anjalia2/ECE-445-Project/README.md

# Circle of Life: Automated Desktop Aquaponics System

## Team Members: Anjali Aravindhan, Aishwarya Manoj, Estela Medrano-Gutierrez
