anjalia2/ECE-445-Project/notebooks/estela/april24.md

# ECE 445 Lab Notebook
###### By Estela Medrano

---

# Date: April 24, 2026

## Objective

Wire everything up for pre-demo testing.

---

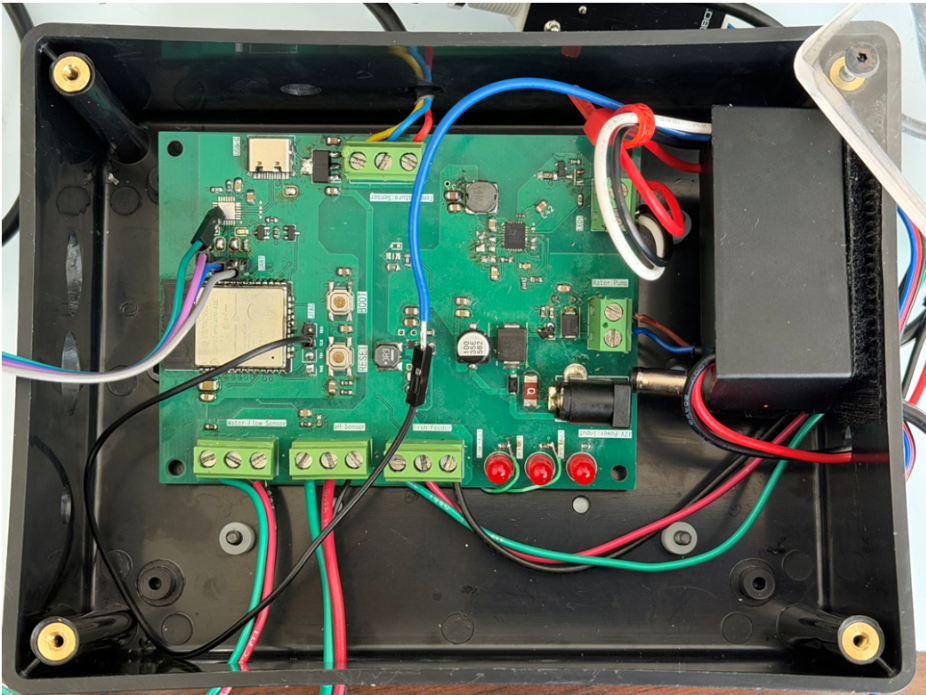
[picture p38: notebooks/estela/Pictures/figure_25.png]
Picture of all
