anjalia2/ECE-445-Project/notebooks/estela/april26.md

# ECE 445 Lab Notebook
###### By Estela Medrano

---

# Date: April 26, 2026

## Objective

Verify voltages.

---

Multimeter tested all voltage measurements:

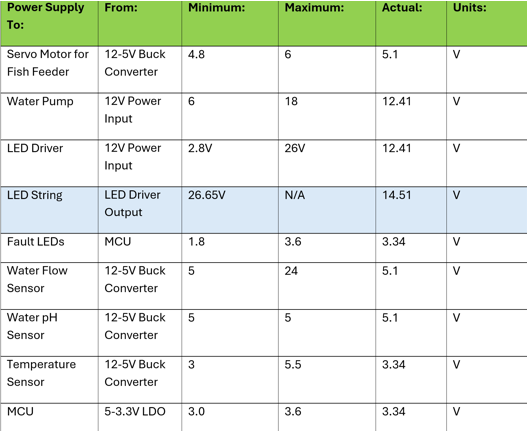
[picture p43: notebooks/estela/Pictures/figure_24.png]
Multimeter measurements
