anjalia2/ECE-445-Project/notebooks/estela/february24.md

# ECE 445 Lab Notebook
###### By Estela Medrano

---

# Date: February 24, 2026

## Objective

Review Anjali’s PCB.

---

Main things to fix:

- Trace width is too small considering the current going through the LEDs.
- As an example, told Anjali that the trace should be compared to the connector hole width and LED pad/current path sizing.
- Told her to change some right angles, should be at least 45 degrees.
- The GND plane and power was switched around.
