anjalia2/ECE-445-Project/notebooks/estela/march24.md

# ECE 445 Lab Notebook
###### By Estela Medrano

---

# Date: March 24, 2026

## Objective

Test 12 V input, solder buck converter, and solder sensors.

---

- Test 12V input, solder buck converter and sensors

- Soldered buck converter and other small ICs. They were tiny. I hand soldered the buck converter, and used solder paste and a heat gun for the LED driver.

- Tested 12V with charger. Measures around 12.41V. A bit higher than expected, but nothing bad.

- Tested buck converter. I worked my first try! Measured around 5.01V

- Soldered all connectors. Will let the others finish testing them whenever they have time. We should be able to do our exact breadboard test in this PCB now.
