anjalia2/ECE-445-Project/notebooks/estela/february27.md

# ECE 445 Lab Notebook
###### By Estela Medrano

---

# Date: February 27, 2026

## Objective

Draw visual aid for design review.

---

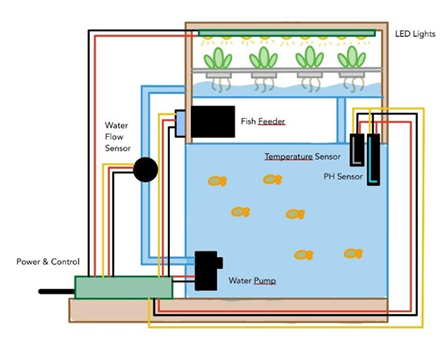
[picture p54: notebooks/estela/Pictures/figure_12.png]
Visual Aid
