anjalia2/ECE-445-Project/notebooks/estela/Pictures/figure_1.png

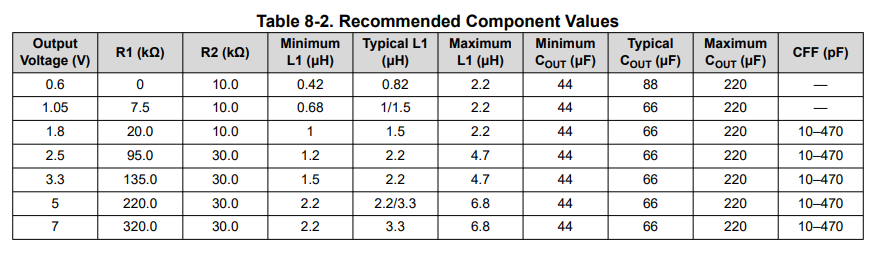
notebooks/estela/Pictures/figure_1.png
