anjalia2/ECE-445-Project/notebooks/estela/Pictures/figure_2.png

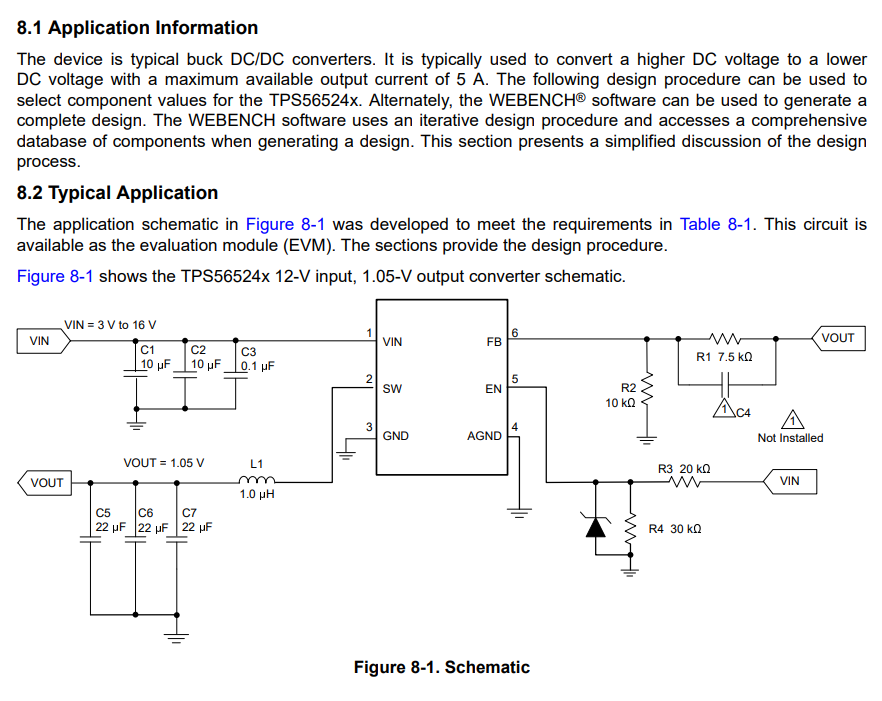
notebooks/estela/Pictures/figure_2.png
