anjalia2/ECE-445-Project/notebooks/estela/Pictures/figure_3.png

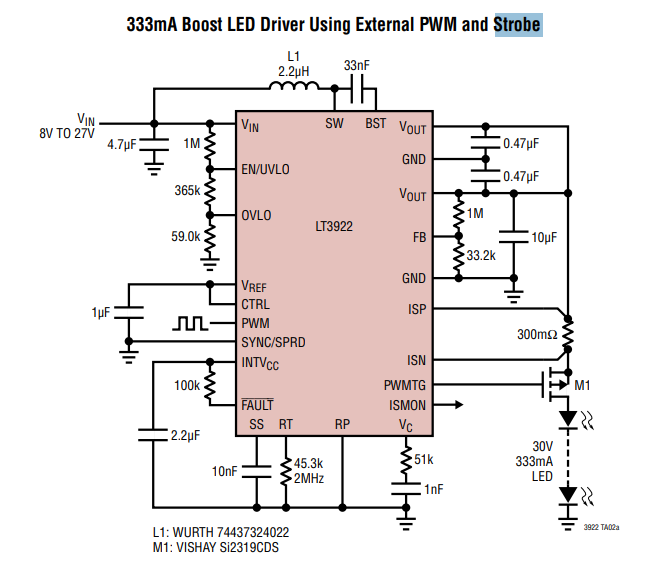
notebooks/estela/Pictures/figure_3.png
