anjalia2/ECE-445-Project/notebooks/estela/Pictures/figure_6.png

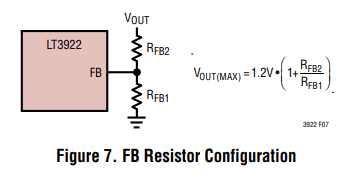
notebooks/estela/Pictures/figure_6.png
