anjalia2/ECE-445-Project/boards/parts/ASMW-LL00-NKM0E.stp

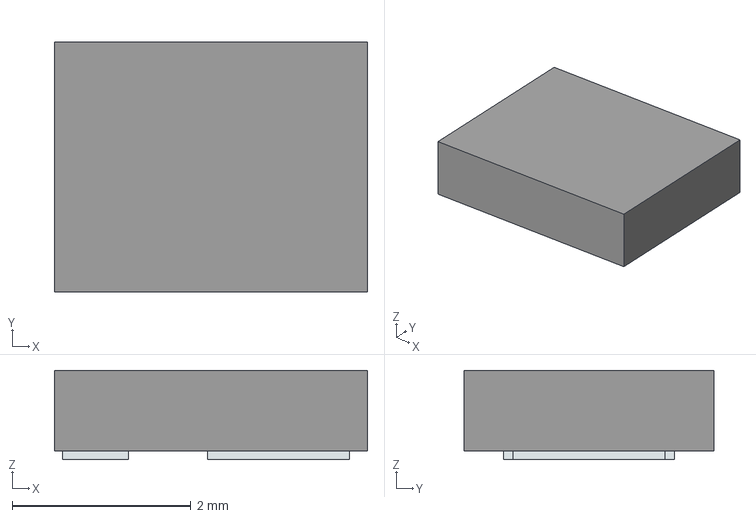
[picture p61: CAD file, 2026-02-19]
boards/parts/ASMW-LL00-NKM0E.stp
3.50 x 2.80 x 1.00 mm
Pins
