anjalia2/ECE-445-Project/boards/parts/ASMW-L300-AFH0E.stp

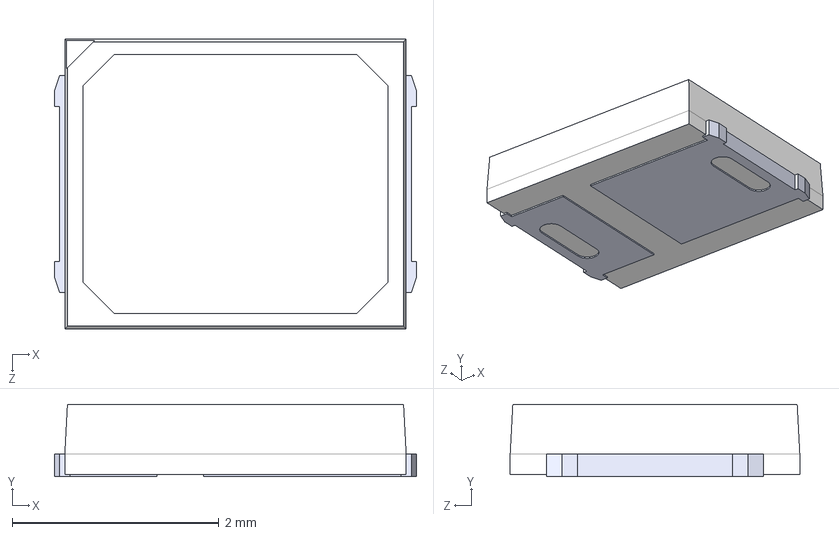
[picture p62: CAD file, 2026-02-19]
boards/parts/ASMW-L300-AFH0E.stp
3.50 x 0.7 x 2.80 mm
