anjalia2/ECE-445-Project/boards/parts/LIB_RC0805FR-0730KL/RC0805FR-0730KL/3D/RC0805FR-0730KL.stp

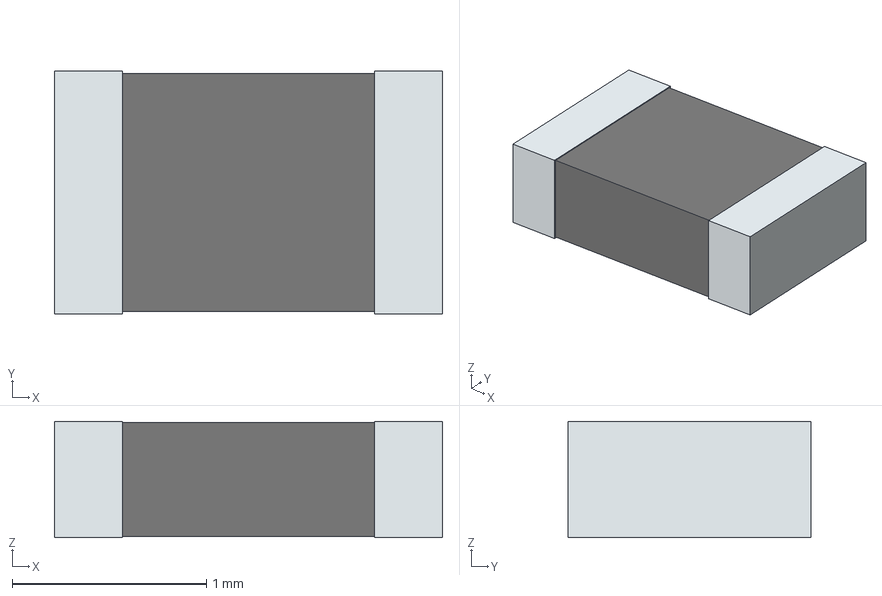
[picture p64: CAD file, 2026-02-20]
boards/parts/LIB_RC0805FR-0730KL/RC0805FR-0730KL/3D/RC0805FR-0730KL.stp
2.00 x 1.25 x 0.6 mm
term1
term2
