anjalia2/ECE-445-Project/boards/parts/SMF12A/SMF12A.step

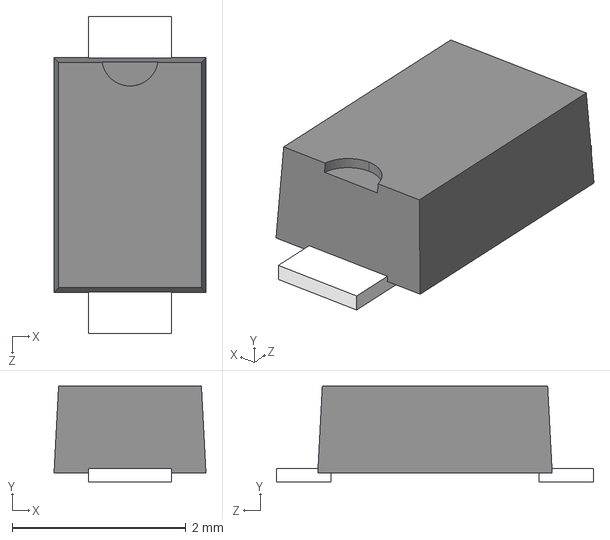
[picture p65: CAD file, 2026-02-20]
boards/parts/SMF12A/SMF12A.step
1.75 x 1.10 x 3.65 mm
