anjalia2/ECE-445-Project/boards/parts/TPD1E05U06QDPYRQ1.stp

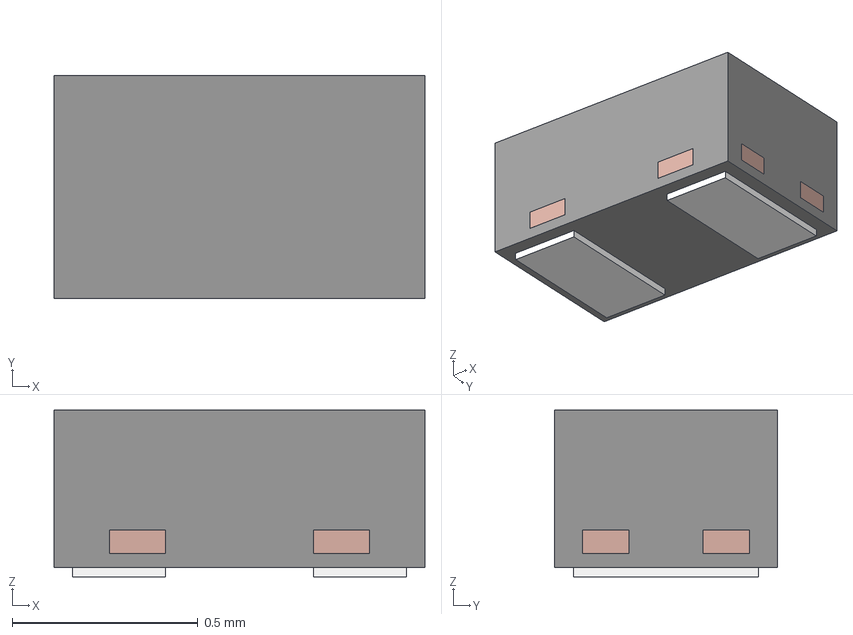
[picture p66: CAD file, 2026-02-23]
boards/parts/TPD1E05U06QDPYRQ1.stp
1.00 x 0.6 x 0.45 mm
BODY-SON
FRAME-DPY0002A
