anjalia2/ECE-445-Project/boards/parts/ESP32-S3-WROOM-1-N8.stp

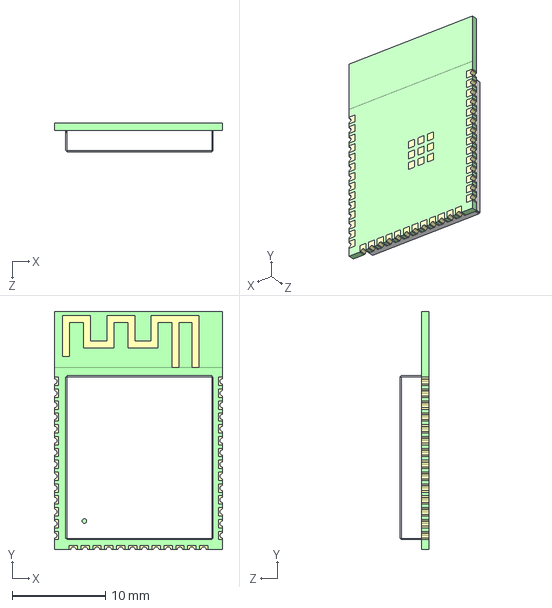
[picture p67: CAD file, 2026-02-23]
boards/parts/ESP32-S3-WROOM-1-N8.stp
18.0 x 25.5 x 3.10 mm
