anjalia2/ECE-445-Project/boards/parts/SP0506BAATG.stp

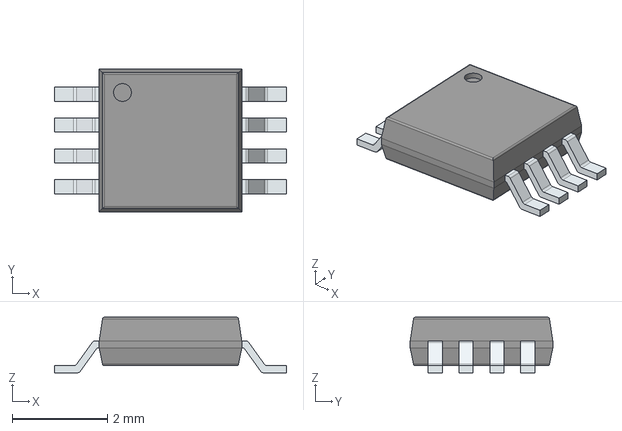
[picture p68: CAD file, 2026-02-21]
boards/parts/SP0506BAATG.stp
4.88 x 3.00 x 1.17 mm
PinsArrayLR
