anjalia2/ECE-445-Project/boards/parts/SS8050-G.stp

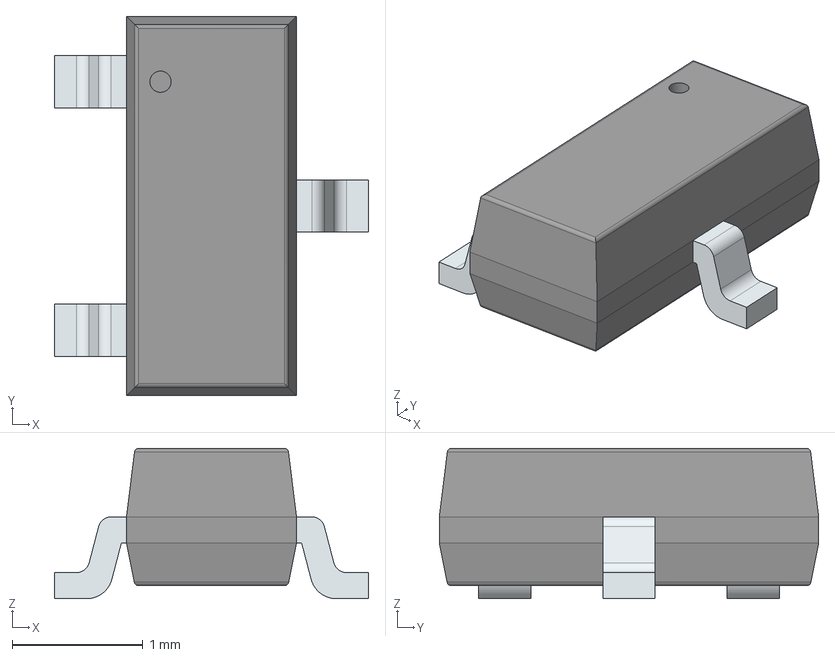
[picture p69: CAD file, 2026-02-21]
boards/parts/SS8050-G.stp
2.40 x 2.90 x 1.15 mm
PinsArrayL
FilletPinR
