anjalia2/ECE-445-Project/boards/parts/CP2102C-A01-GQFN28.stp

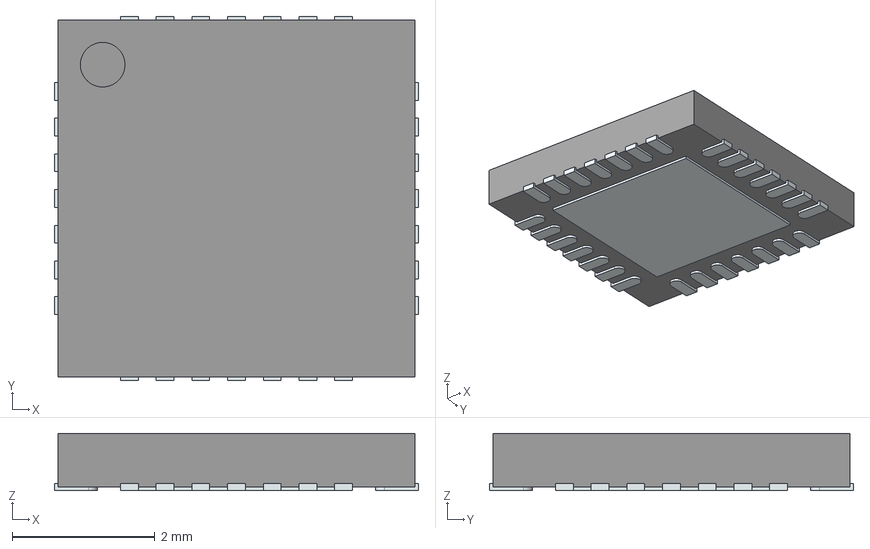
[picture p70: CAD file, 2026-02-21]
boards/parts/CP2102C-A01-GQFN28.stp
5.10 x 5.10 x 0.8 mm
ThermalPin
PinsArrayLR
PinsArrayTB
