anjalia2/ECE-445-Project/boards/parts/SP0503BAHTG.stp

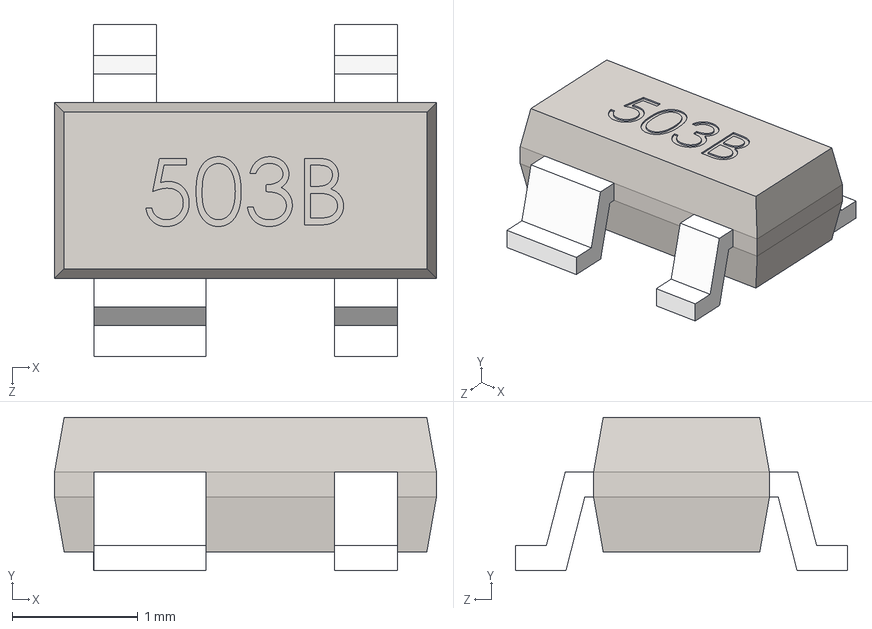
[picture p71: CAD file, 2026-02-21]
boards/parts/SP0503BAHTG.stp
3.04 x 1.22 x 2.64 mm
