anjalia2/ECE-445-Project/boards/parts/TXU0101DBVR.stp

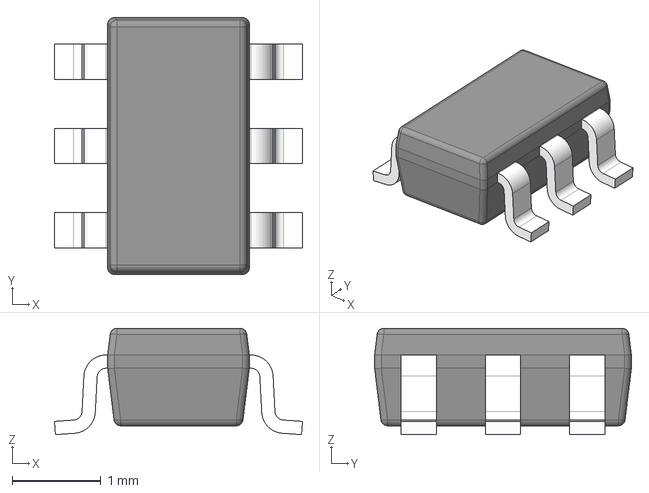
[picture p72: CAD file, 2026-02-20]
boards/parts/TXU0101DBVR.stp
2.80 x 2.90 x 1.20 mm
BODY-SOT
LEAD-SOT x 6
