anjalia2/ECE-445-Project/boards/parts/TC1262-3.3VDB.stp

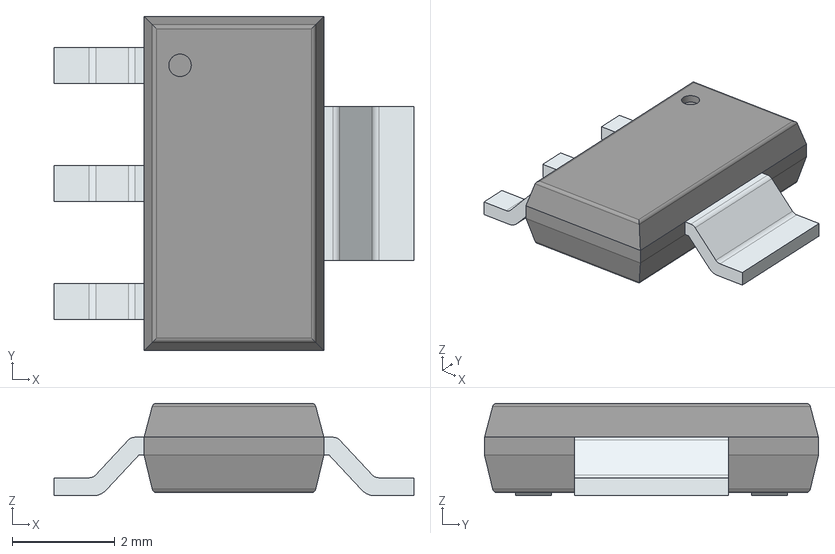
[picture p73: CAD file, 2026-02-20]
boards/parts/TC1262-3.3VDB.stp
7.00 x 6.50 x 1.80 mm
PinsArrayL
FilletPinR
