anjalia2/ECE-445-Project/boards/parts/CSR1206FTR500.stp

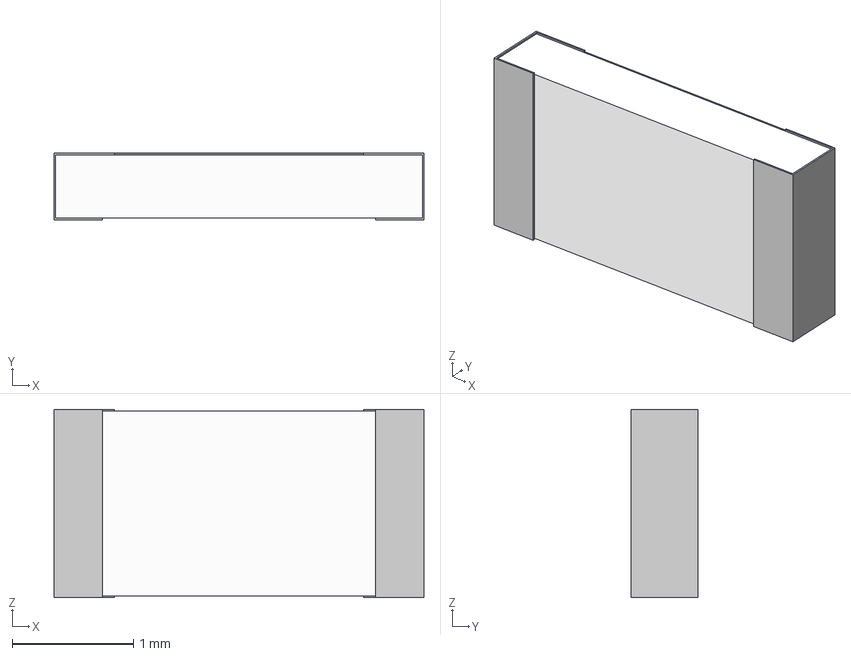
[picture p74: CAD file, 2026-02-20]
boards/parts/CSR1206FTR500.stp
3.05 x 0.55 x 1.55 mm
