anjalia2/ECE-445-Project/boards/parts/SI2319CDS-T1-GE3.stp

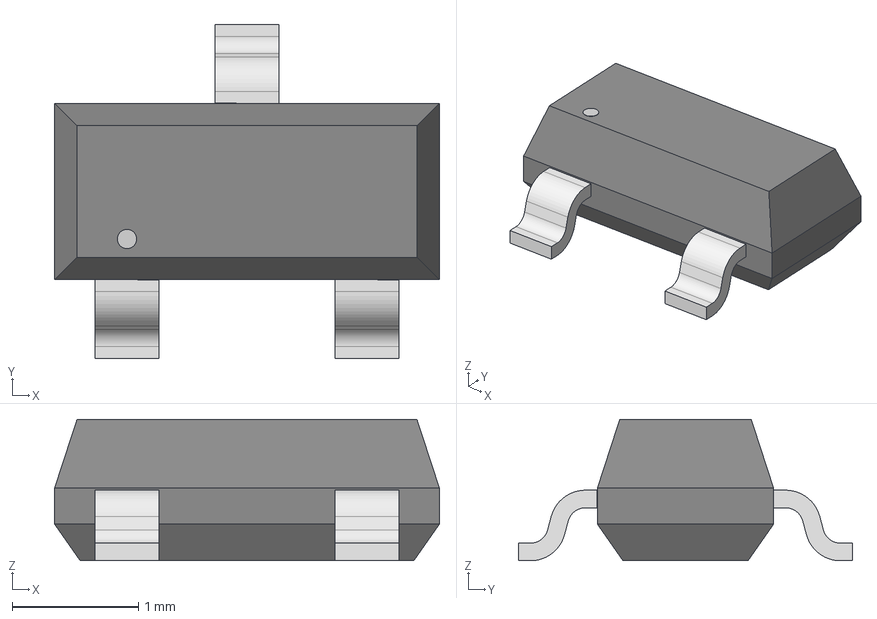
[picture p75: CAD file, 2026-02-20]
boards/parts/SI2319CDS-T1-GE3.stp
3.05 x 2.64 x 1.12 mm
