anjalia2/ECE-445-Project/boards/parts/LT3922EUFD#PBF.stp

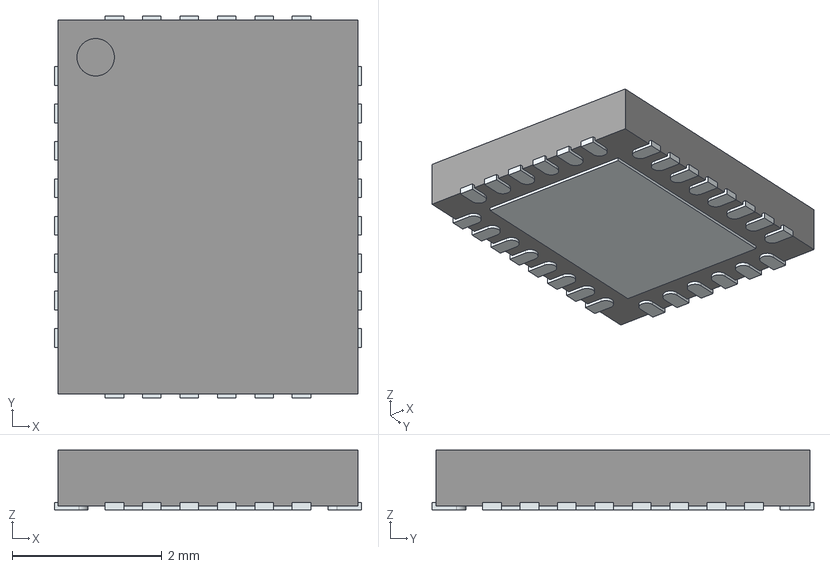
[picture p77: CAD file, 2026-02-20]
boards/parts/LT3922EUFD#PBF.stp
4.10 x 5.10 x 0.8 mm
ThermalPin
PinsArrayLR
PinsArrayTB
