anjalia2/ECE-445-Project/boards/parts/RC0603FR-7W10KL.stp

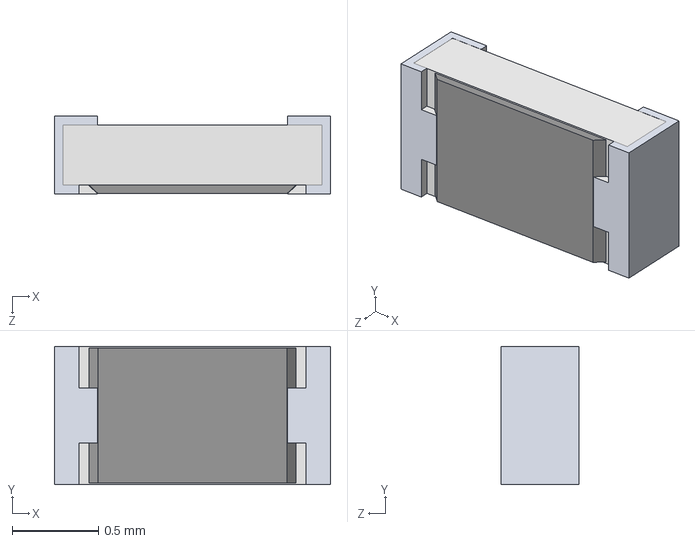
[picture p78: CAD file, 2026-02-20]
boards/parts/RC0603FR-7W10KL.stp
1.60 x 0.8 x 0.45 mm
