anjalia2/ECE-445-Project/boards/parts/RC1206FR-071M1L.stp

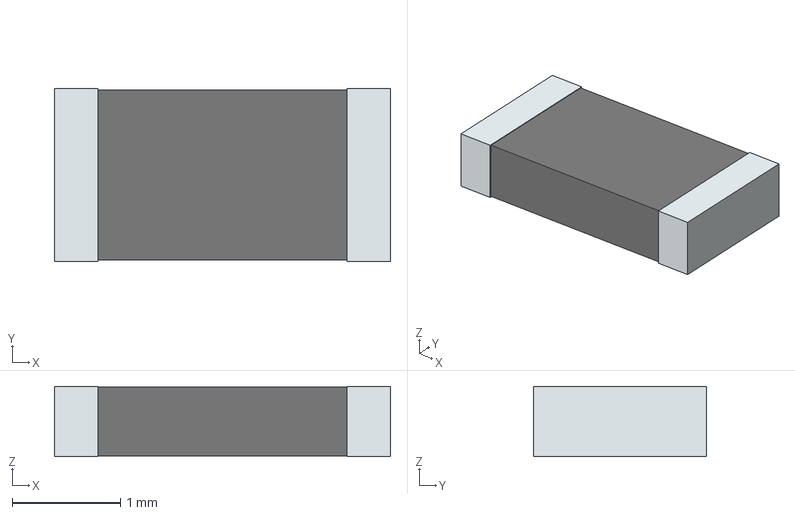
[picture p79: CAD file, 2026-02-20]
boards/parts/RC1206FR-071M1L.stp
3.10 x 1.60 x 0.65 mm
term1
term2
