anjalia2/ECE-445-Project/boards/parts/RCWE1206.STEP

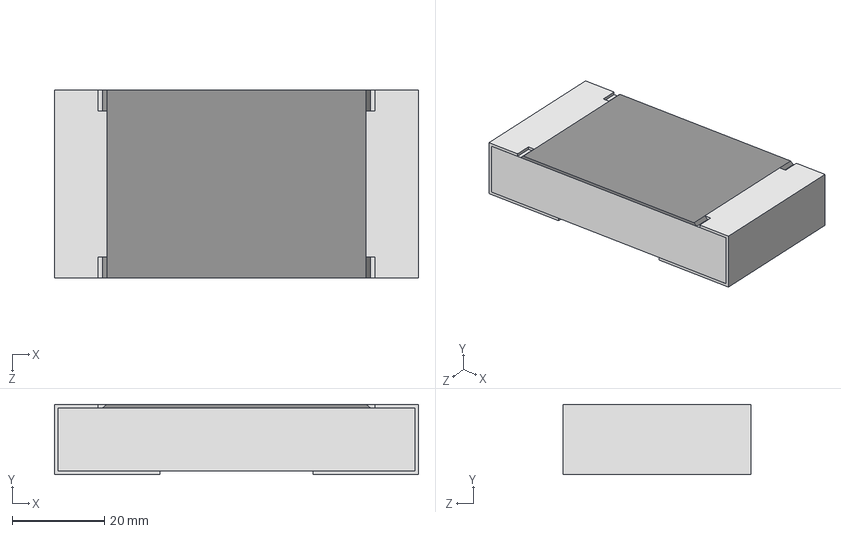
[picture p80: CAD file, 2026-02-20]
boards/parts/RCWE1206.STEP
78.7 x 15.2 x 40.6 mm
