anjalia2/ECE-445-Project/boards/parts/35ZLH220MEFCT78X11.5.stp

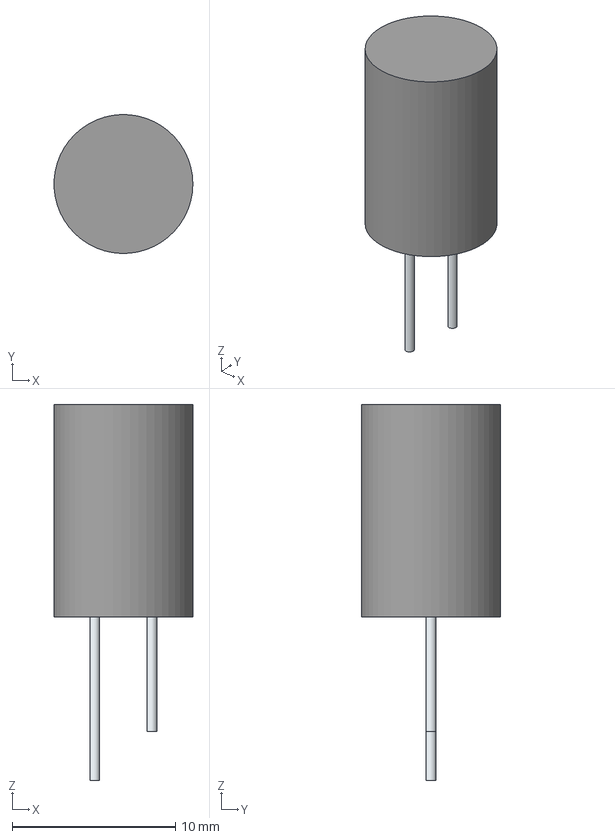
[picture p81: CAD file, 2026-02-20]
boards/parts/35ZLH220MEFCT78X11.5.stp
8.49 x 8.50 x 23.0 mm
SimpleBody
Pin1
Pin2
