anjalia2/ECE-445-Project/boards/parts/TMK107ABJ225KA-T.stp

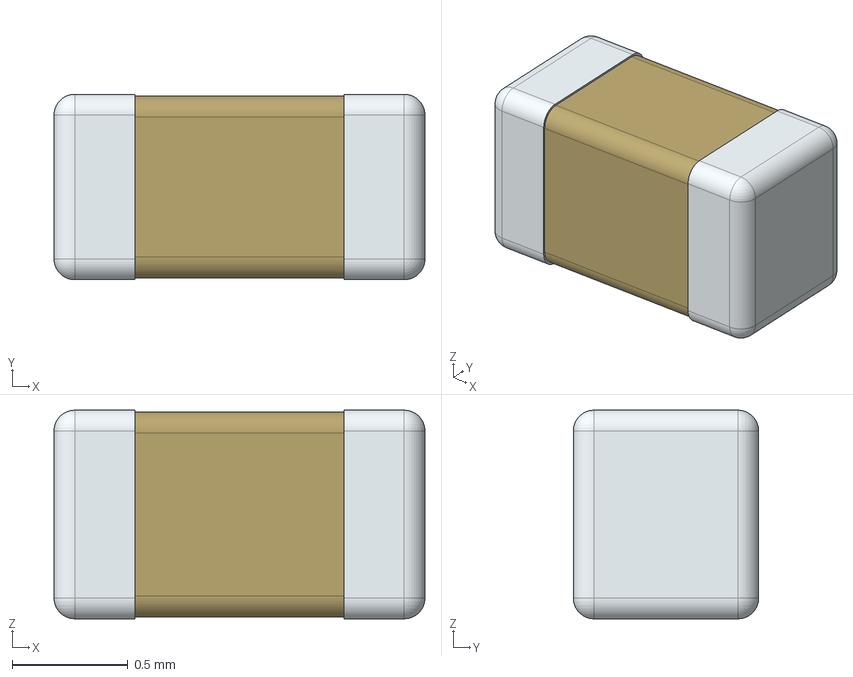
[picture p82: CAD file, 2026-02-20]
boards/parts/TMK107ABJ225KA-T.stp
1.60 x 0.8 x 0.9 mm
