anjalia2/ECE-445-Project/boards/parts/C0603C103K5RACTU.stp

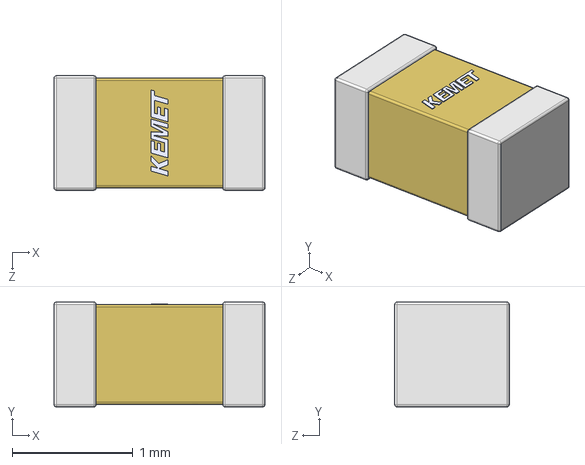
[picture p83: CAD file, 2026-02-20]
boards/parts/C0603C103K5RACTU.stp
1.75 x 0.87 x 0.95 mm
