anjalia2/ECE-445-Project/boards/parts/35PX470MEFC10X12.5.stp

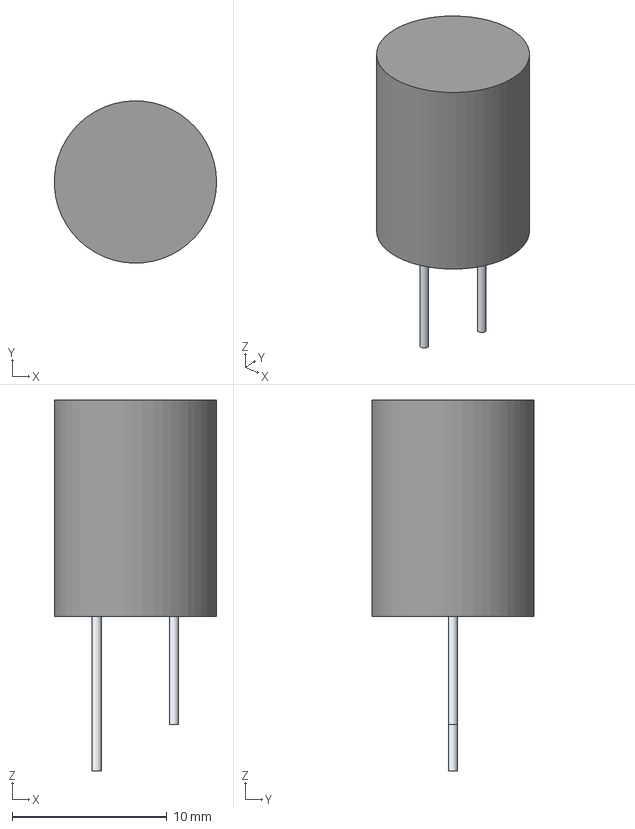
[picture p84: CAD file, 2026-02-20]
boards/parts/35PX470MEFC10X12.5.stp
10.5 x 10.5 x 24.0 mm
SimpleBody
Pin1
Pin2
