anjalia2/ECE-445-Project/boards/parts/NRS5030T3R3MMGJ.stp

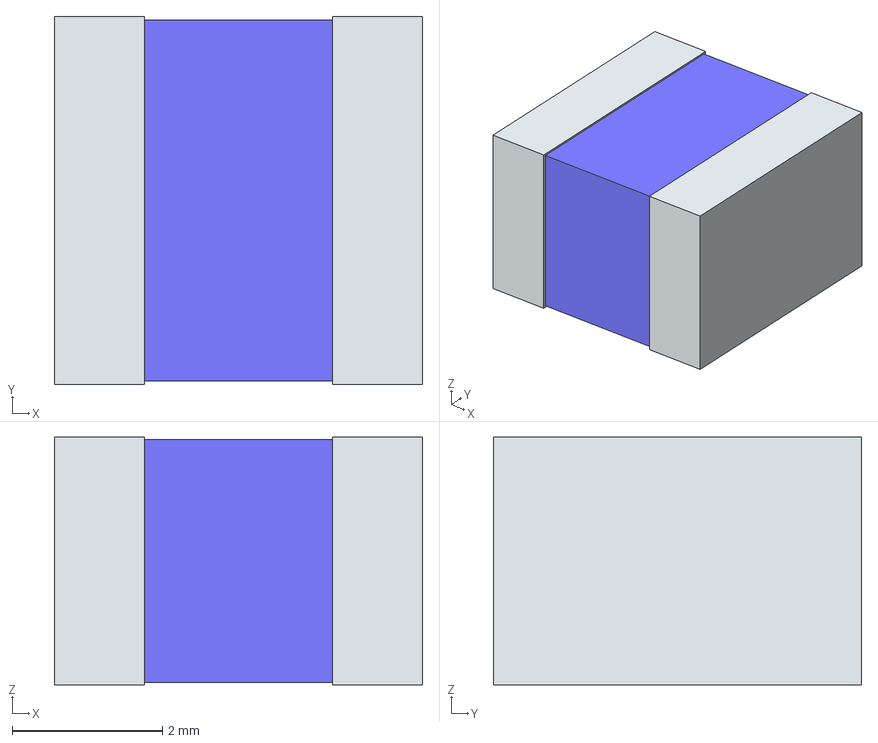
[picture p85: CAD file, 2026-02-20]
boards/parts/NRS5030T3R3MMGJ.stp
4.90 x 4.90 x 3.30 mm
term1
term2
