anjalia2/ECE-445-Project/boards/parts/GRM155R61H474KE11D.stp

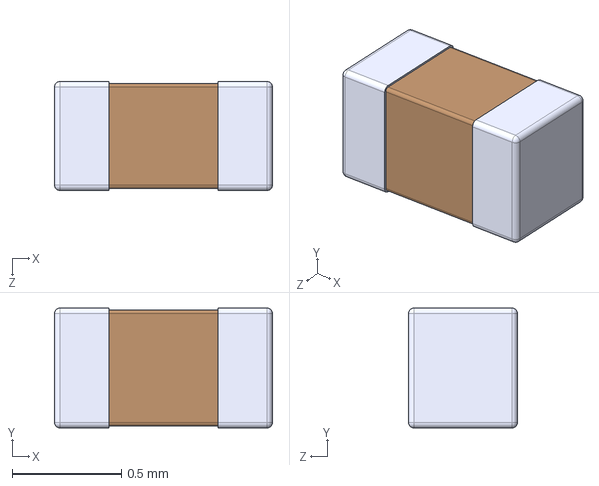
[picture p86: CAD file, 2026-02-20]
boards/parts/GRM155R61H474KE11D.stp
1.00 x 0.55 x 0.5 mm
