anjalia2/ECE-445-Project/boards/parts/GRM155R71H102KA01D.stp

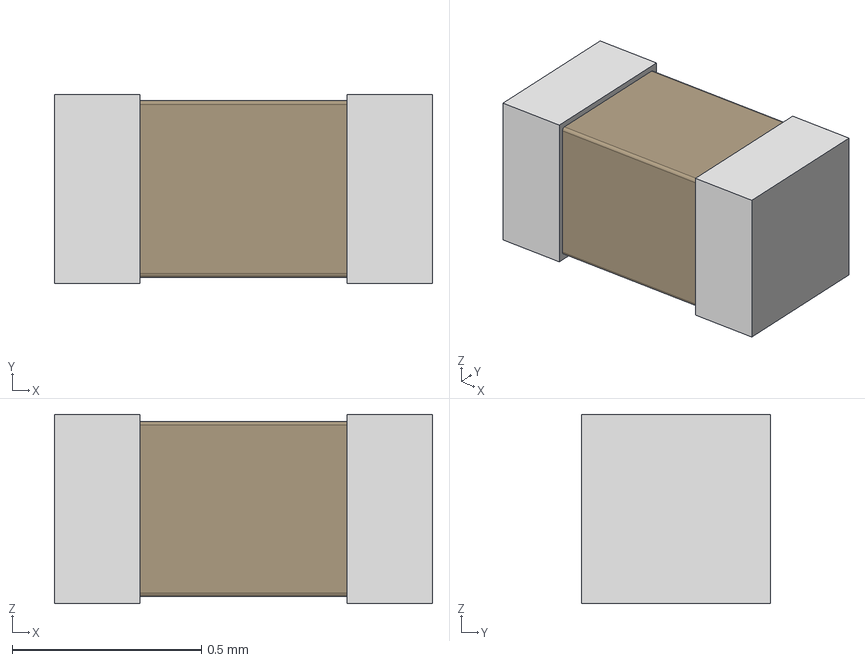
[picture p87: CAD file, 2026-02-20]
boards/parts/GRM155R71H102KA01D.stp
1.00 x 0.5 x 0.5 mm
