anjalia2/ECE-445-Project/boards/parts/TMK316BBJ226ML-T.stp

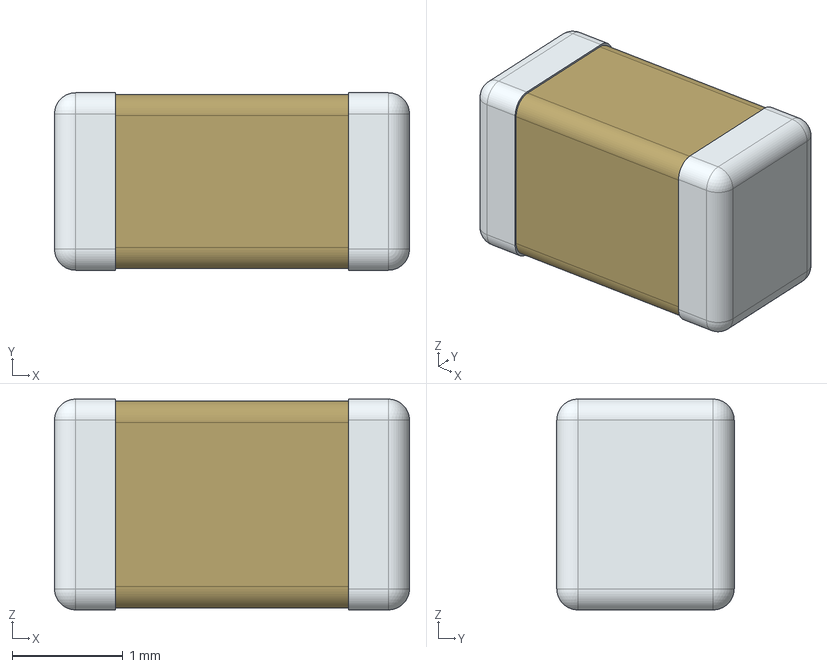
[picture p88: CAD file, 2026-02-20]
boards/parts/TMK316BBJ226ML-T.stp
3.20 x 1.60 x 1.90 mm
