anjalia2/ECE-445-Project/boards/parts/TMK316BJ106KL-T.stp

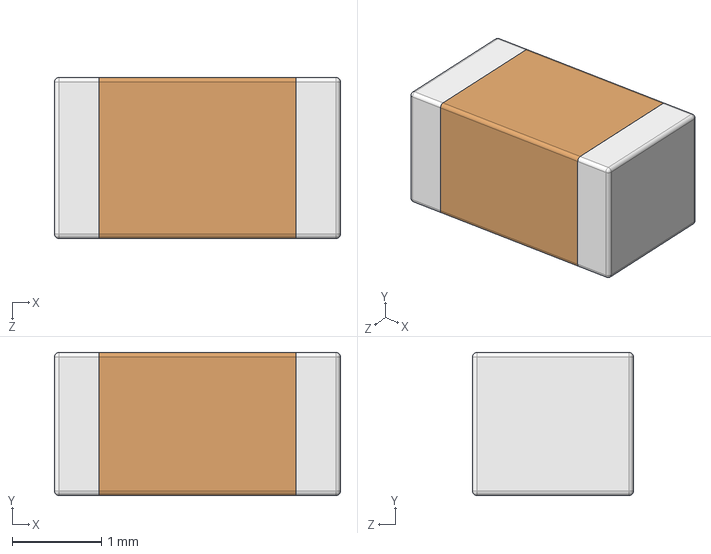
[picture p89: CAD file, 2026-02-20]
boards/parts/TMK316BJ106KL-T.stp
3.20 x 1.60 x 1.80 mm
