anjalia2/ECE-445-Project/boards/parts/50YXJ47M6.3X11.stp

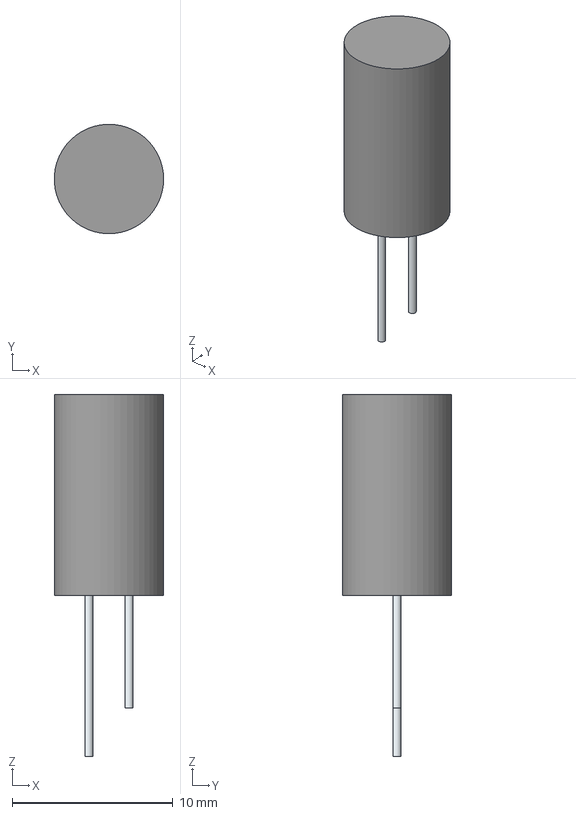
[picture p90: CAD file, 2026-02-20]
boards/parts/50YXJ47M6.3X11.stp
6.79 x 6.80 x 22.5 mm
SimpleBody
Pin1
Pin2
