anjalia2/ECE-445-Project/boards/parts/SRN6045-4R7Y.stp

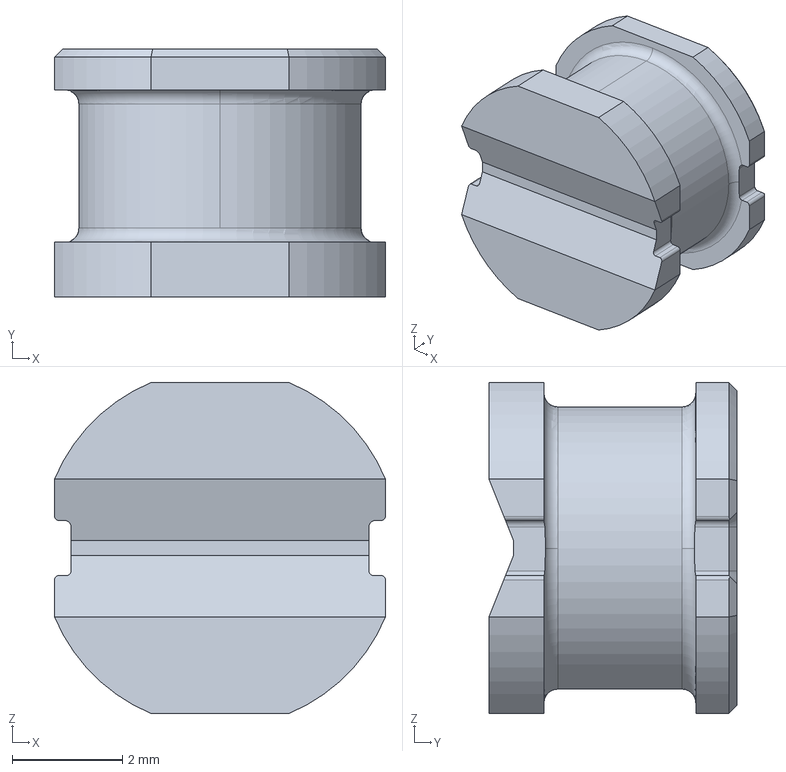
[picture p91: CAD file, 2026-02-20]
boards/parts/SRN6045-4R7Y.stp
6.00 x 4.50 x 6.00 mm
