anjalia2/ECE-445-Project/boards/parts/SK84LQ-TP.stp

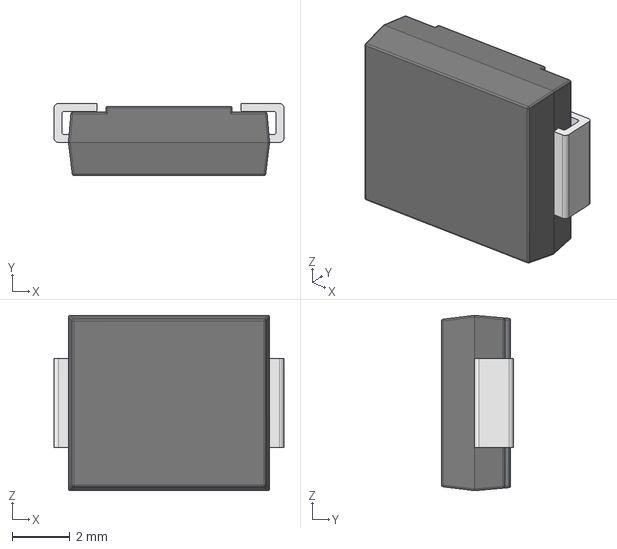
[picture p92: CAD file, 2026-02-19]
boards/parts/SK84LQ-TP.stp
8.00 x 2.50 x 6.10 mm
��2
��1
