anjalia2/ECE-445-Project/boards/parts/BZT52C12-13-F.stp

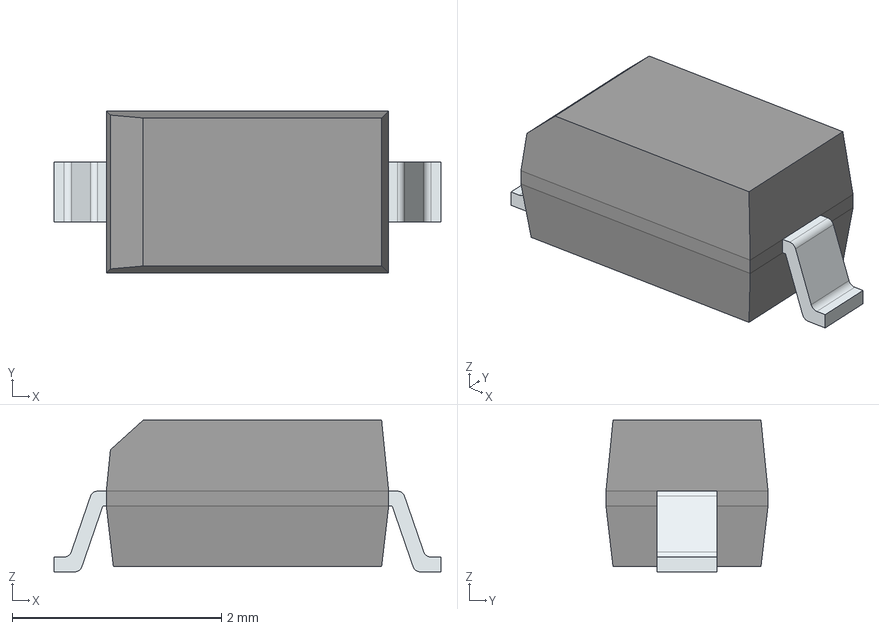
[picture p93: CAD file, 2026-02-19]
boards/parts/BZT52C12-13-F.stp
3.70 x 1.55 x 1.45 mm
FilletPinL
FilletPinR
