anjalia2/ECE-445-Project/boards/parts/RQ5E030AJTCL.stp

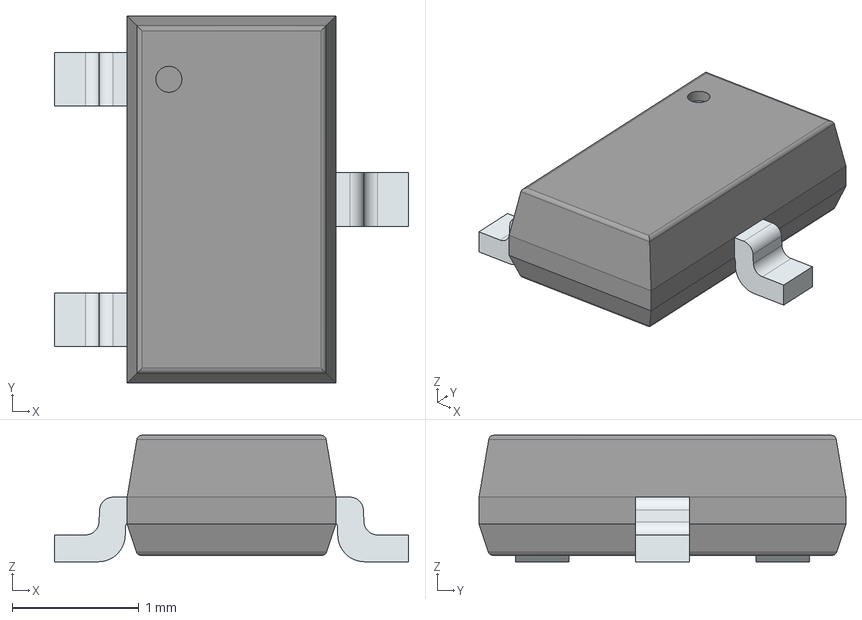
[picture p94: CAD file, 2026-02-19]
boards/parts/RQ5E030AJTCL.stp
2.80 x 2.90 x 1.00 mm
PinsArrayL
FilletPinR
