anjalia2/ECE-445-Project/boards/parts/EEV107M035A9HAA.stp

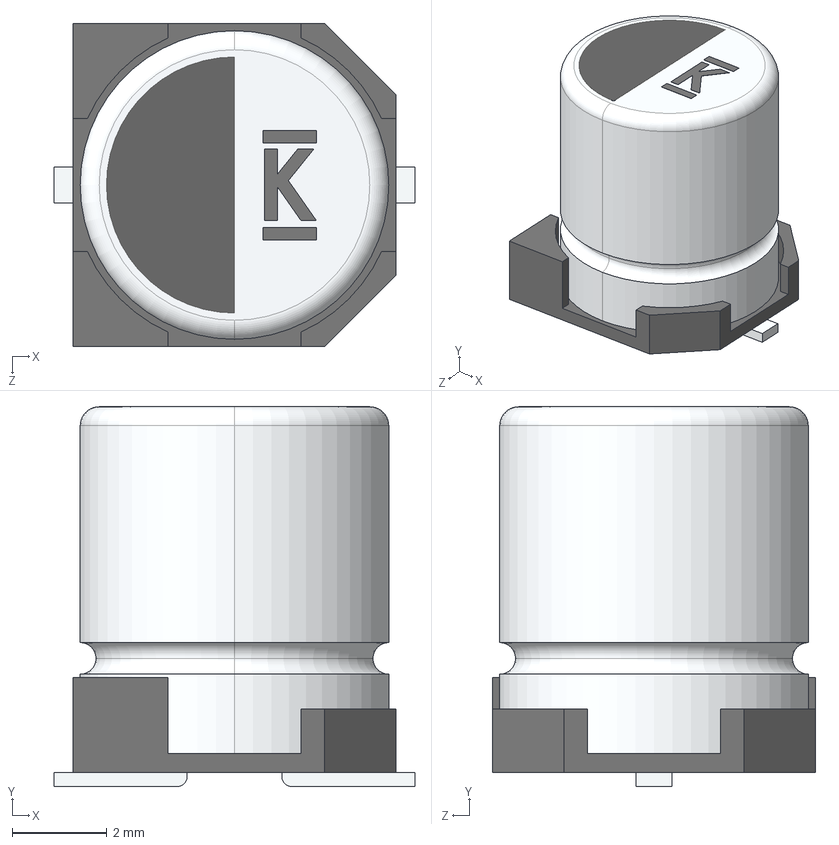
[picture p95: CAD file, 2026-02-19]
boards/parts/EEV107M035A9HAA.stp
7.60 x 8.01 x 6.80 mm
