anjalia2/ECE-445-Project/boards/parts/SF-2410FP1000W-2.stp

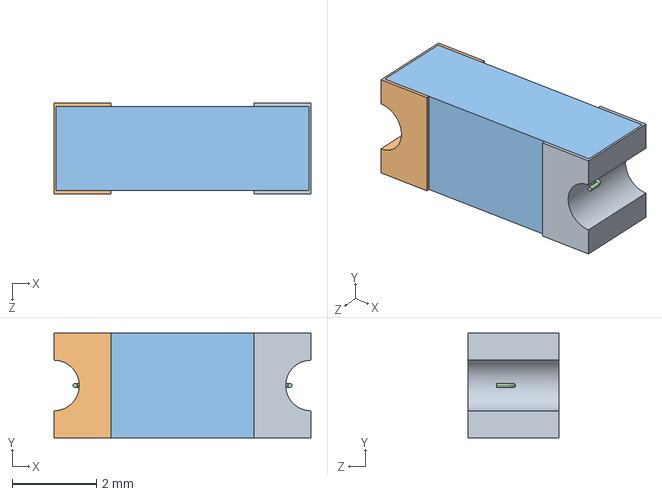
[picture p96: CAD file, 2026-02-19]
boards/parts/SF-2410FP1000W-2.stp
6.10 x 2.49 x 2.16 mm
