anjalia2/ECE-445-Project/boards/parts/GMK212B7105KG-T.stp

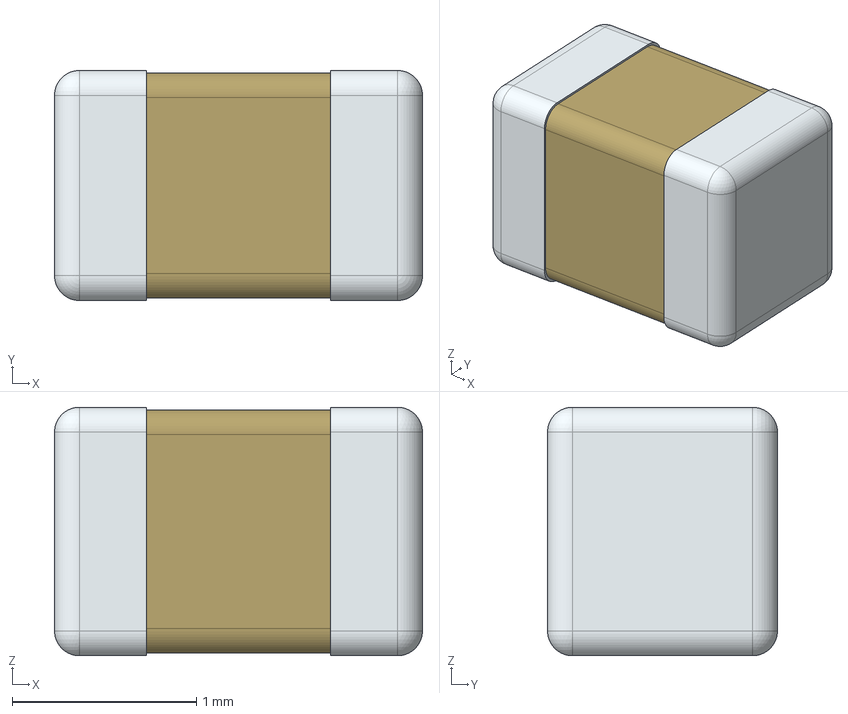
[picture p97: CAD file, 2026-02-19]
boards/parts/GMK212B7105KG-T.stp
2.00 x 1.25 x 1.35 mm
