anjalia2/ECE-445-Project/boards/parts/SS24.stp

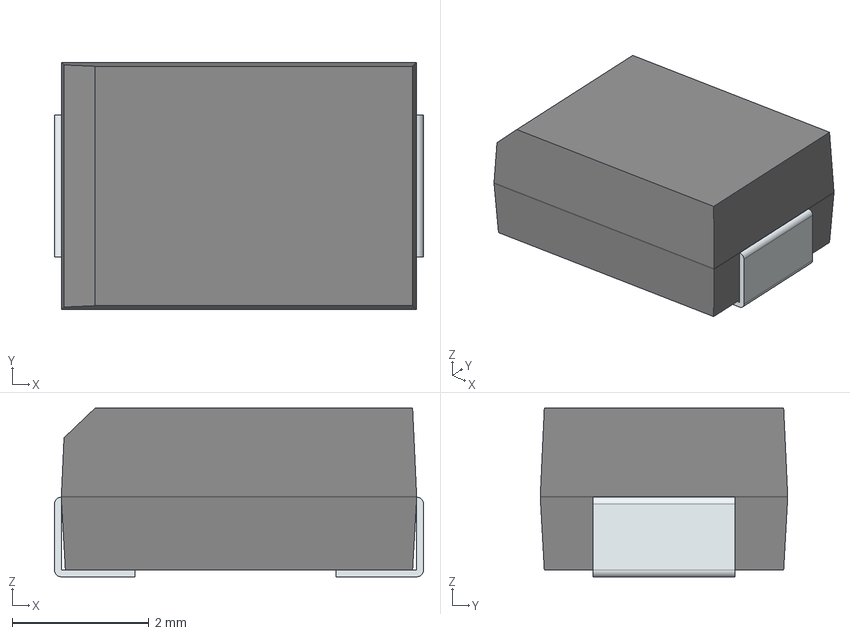
[picture p98: CAD file, 2026-02-19]
boards/parts/SS24.stp
5.41 x 3.62 x 2.47 mm
FilletPin1
FilletPin2
