anjalia2/ECE-445-Project/(list of files, cad)

Other CAD files:
boards/parts/GMK107B7104KAHT.stp
boards/parts/282837-2.stp
boards/parts/691137710003.stp
boards/parts/694108301002.stp
boards/parts/LIB_RC0805FR-0730KL/RC0805FR-0730KL/DEHDL/rc0805fr_0730kl/chips/chips.prt
boards/parts/TPS565242DRLR.stp
