anjalia2/ECE-445-Project/(list of files, drawings)

Other design files:
boards/parts/LIB_RC0805FR-0730KL/RC0805FR-0730KL/Altium/RC0805FR-0730KL.SchLib
boards/parts/LIB_RC0805FR-0730KL/RC0805FR-0730KL/Altium/RESC2012X60N.PcbLib
