anjalia2/ECE-445-Project/boards/circle_of_life_v3/circle_of_life_v2/circle_of_life_v2.kicad_pcb

## KiCad design boards/circle_of_life_v3/circle_of_life_v2/circle_of_life_v2.kicad_pcb (2026-05-07)

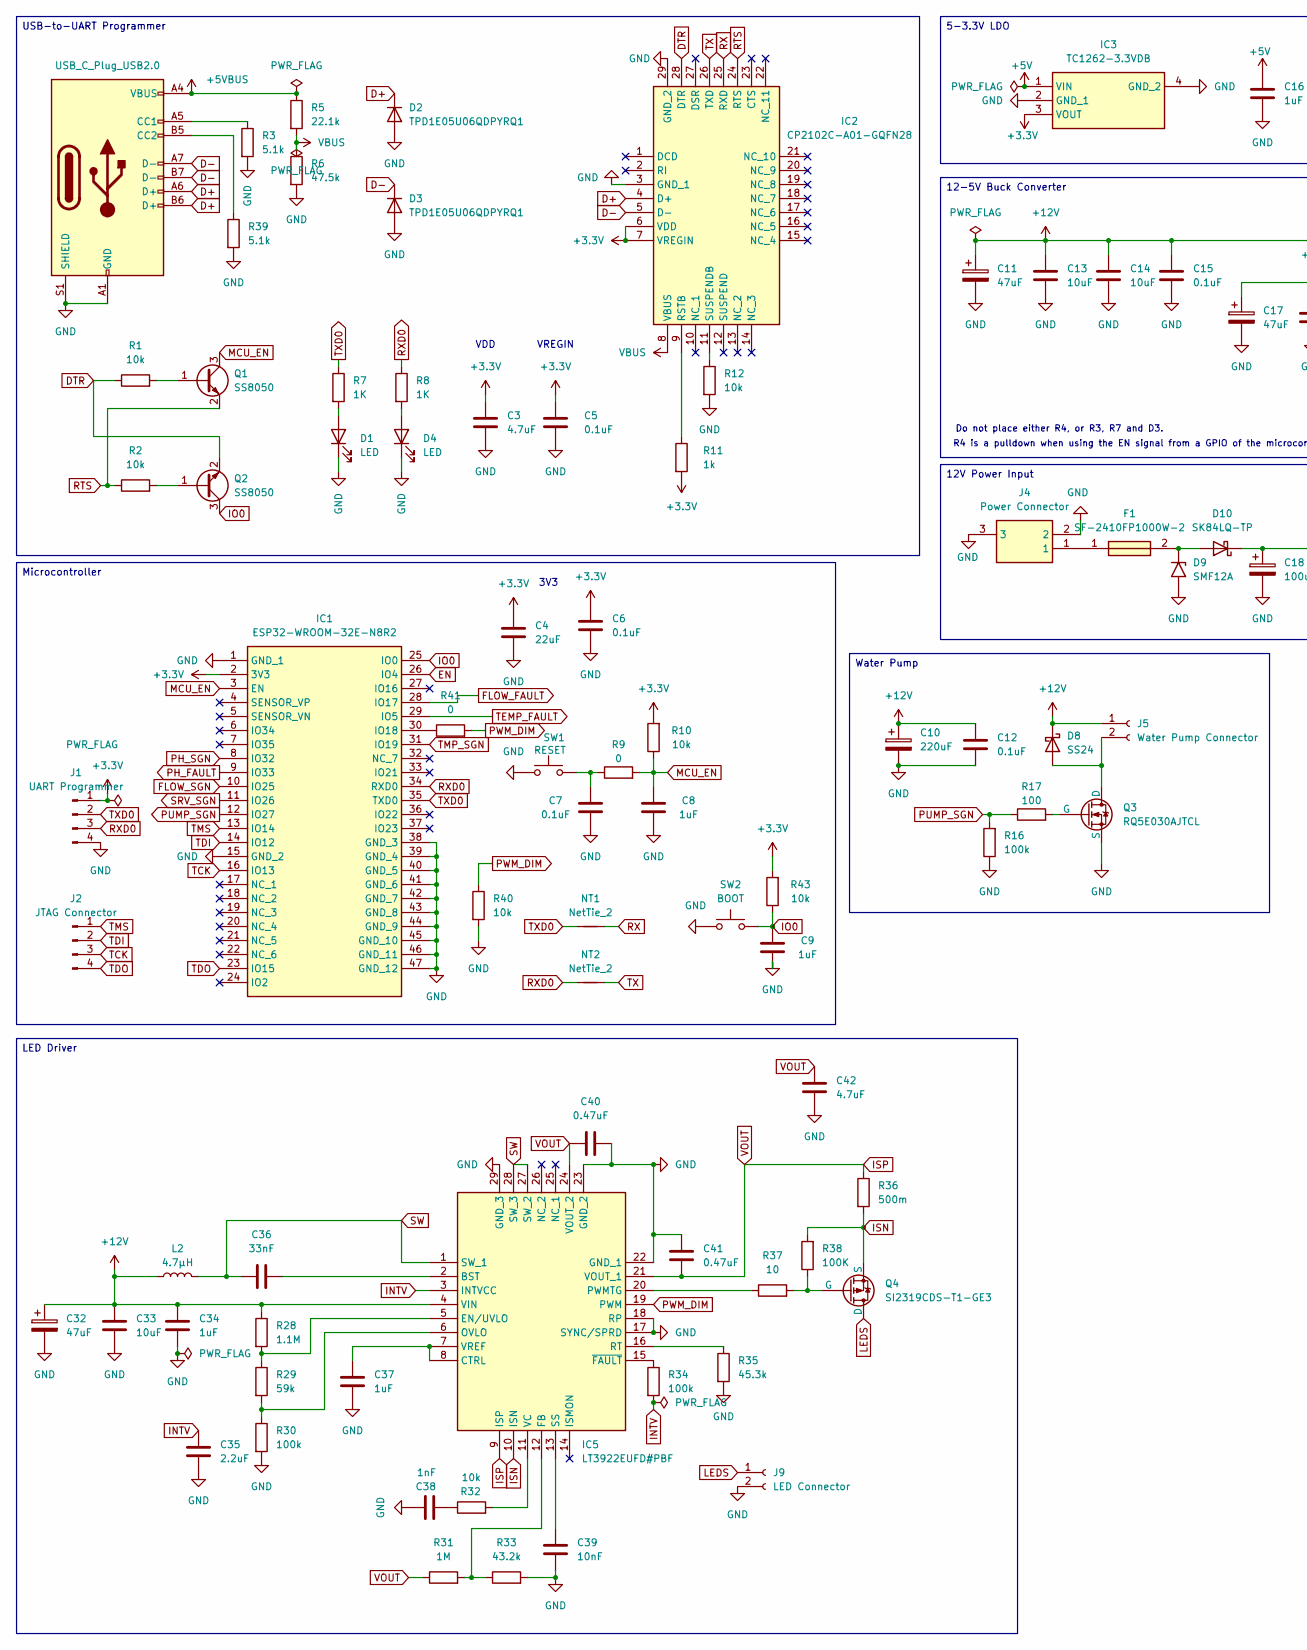
[picture p99: schematic circle_of_life_v2.kicad_sch, part in row 1, column 1]

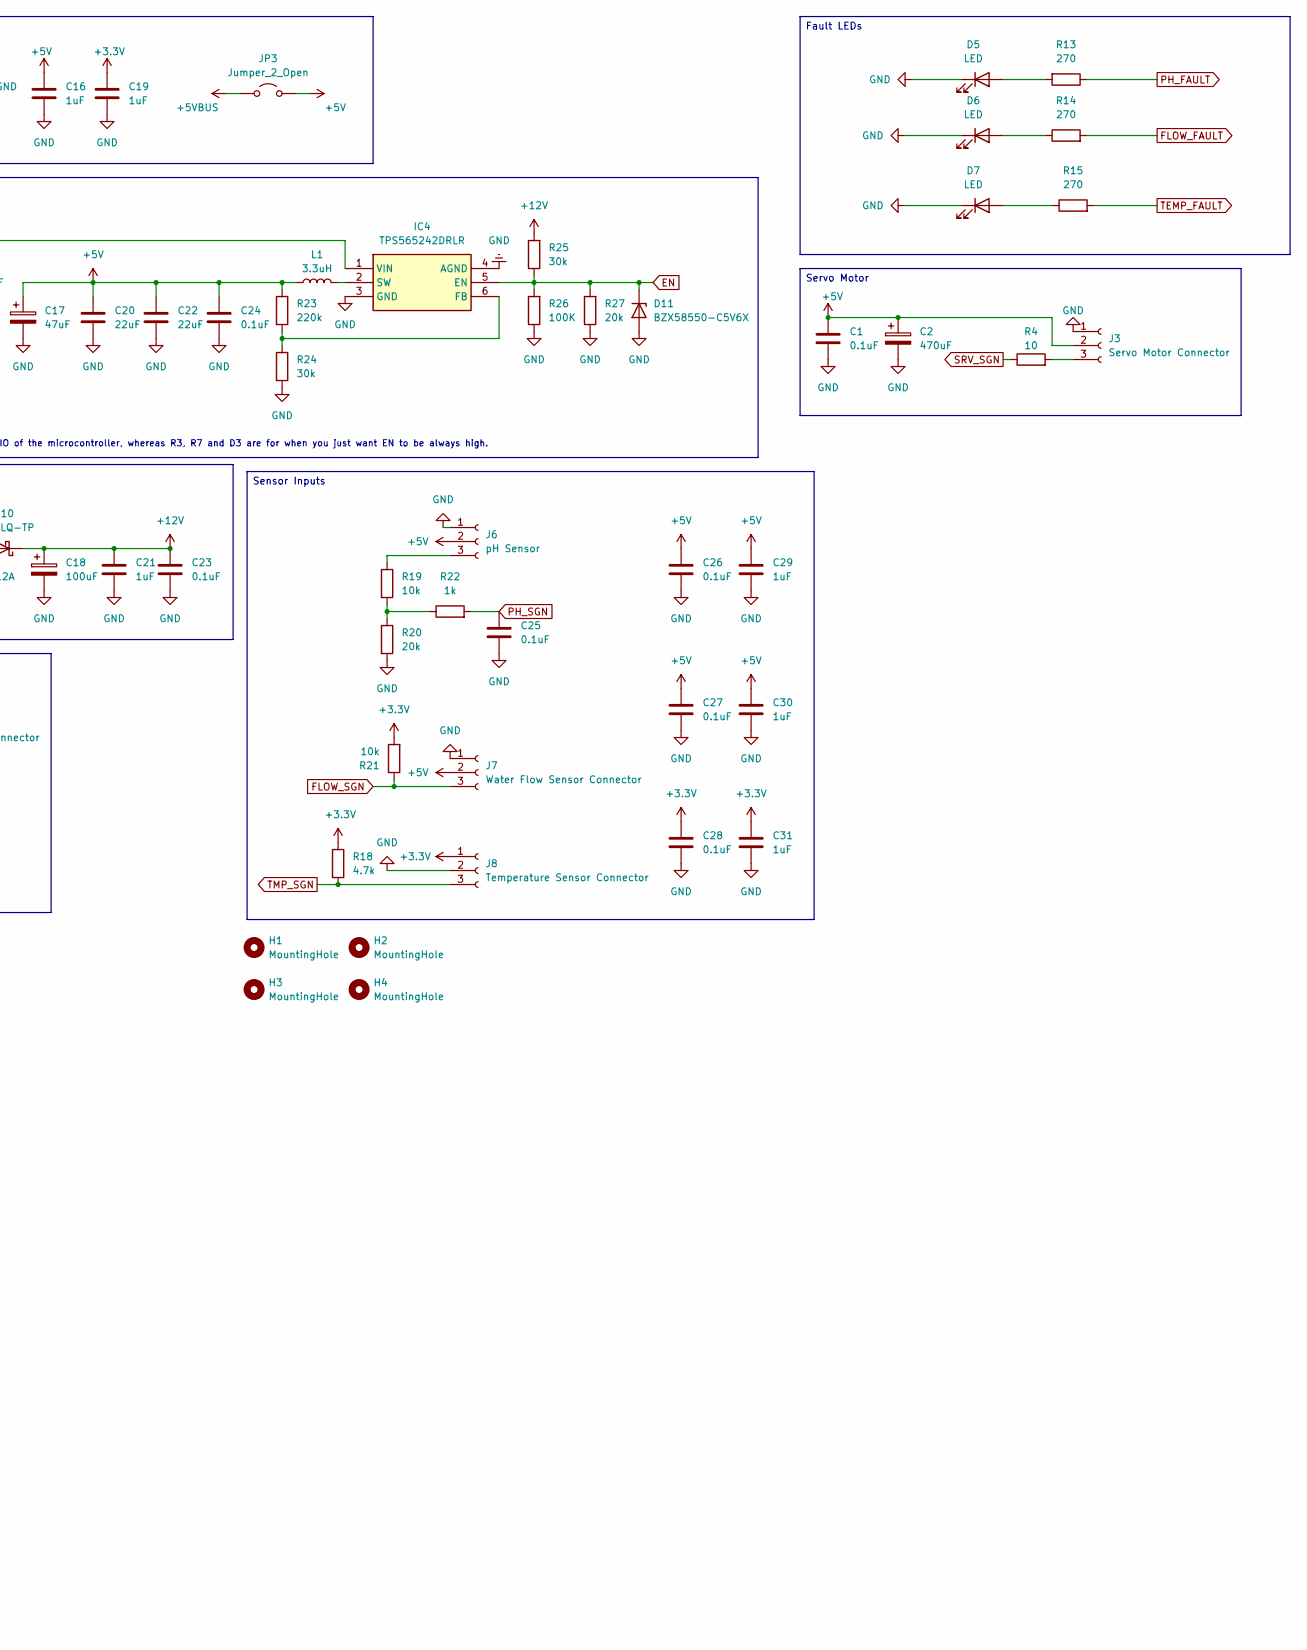
[picture p100: schematic circle_of_life_v2.kicad_sch, part in row 1, column 2]

Parts:
C1, C5, C6, C7, C12, C23, C24, C25, C26, C27, C28: 0.1uF; C_0805_2012Metric
C2: 470uF; CAPPRD500W60D1025H1400
C3, C42: 4.7uF; C_0805_2012Metric
C4, C20, C22: 22uF; CAPC3216X190N
C8, C9, C16, C19, C21, C29, C30, C31, C34, C37: 1uF; C_0805_2012Metric
C10: 220uF; CAPPRD350W60D825H1300
C11, C17, C32: 47uF; CAPPRD250W50D655H1250
C13, C14: 10uF; C_0805_2012Metric
C15: 0.1uF; C_0805_2012Metric_Pad1.18x1.45mm_HandSolder
C18: 100uF; CAPAE630X800N
C33: 10uF; R_0805_2012Metric_Pad1.20x1.40mm_HandSolder
C35: 2.2uF; CAPC1608X90N
C36: 33nF; 0805_AVX
C38: 1nF; C_0805_2012Metric
C39: 10nF; C_0603_1608Metric
C40, C41: 0.47uF; GRM15x
D1, D4: LED; LED_0603_1608Metric
D2, D3: TPD1E05U06QDPYRQ1; DPY_R-PX1SON-N2_
D5, D6, D7: LED; LED_D5.0mm
D8: SS24; DIOM5436X247N
D9: SMF12A; TVS_SMF12A
D10: SK84LQ-TP; DIOM7959X262N
D11: BZX58550-C5V6X; D_SOD-523
F1: SF-2410FP1000W-2; FUSC6125X236N; Mouser Part Number 652-SF-2410FP1000W-2
H1, H2, H3, H4: MountingHole; MountingHole_3.2mm_M3_ISO7380
IC1: ESP32-WROOM-32E-N8R2; ESP32WROOM32EN8R2; Mouser Part Number 356-ESP32WRM32EN8R2
IC2: CP2102C-A01-GQFN28; QFN50P500X500X80-29N-D; Mouser Part Number 634-P2102CA01GQFN28
IC3: TC1262-3.3VDB; SOT230P700X180-4N; Mouser Part Number 579-TC1262-3.3VDB
IC4: TPS565242DRLR; SOTFL50P160X60-6N; Mouser Part Number 595-TPS565242DRLR
IC5: LT3922EUFD#PBF; QFN50P400X500X80-29N-D; Mouser Part Number 584-LT3922EUFD#PBF
J1: UART Programmer; PinHeader_1x04_P2.54mm_Vertical
J2: JTAG Connector; PinHeader_1x04_P2.54mm_Vertical
J3: Servo Motor Connector; 691137710003
J4: Power Connector; 694108301002; Mouser Part Number 710-694108301002
J5: Water Pump Connector; 2828372
J6: pH Sensor; 691137710003
J7: Water Flow Sensor Connector; 691137710003
J8: Temperature Sensor Connector; 691137710003
J9: LED Connector; 2828372
JP3: Jumper_2_Open; SolderJumper-2_P1.3mm_Open_RoundedPad1.0x1.5mm
L1: 3.3uH; INDC4949X330N
L2: 4.7µH; SRN6045_1
NT1, NT2: NetTie_2; NetTie-2_SMD_Pad0.5mm
P1: USB_C_Plug_USB2.0; USB_C_Receptacle_HRO_TYPE-C-31-M-12
Q1, Q2: SS8050; SOT-23
Q3: RQ5E030AJTCL; SOT95P280X100-3N
Q4: SI2319CDS-T1-GE3; SOT95P237X112-3N
R1, R2, R12, R43: 10k; R_0603_1608Metric
R3, R39: 5.1k; R_0603_1608Metric
R4, R37: 10; RESC1608X55N
R5: 22.1k; R_0603_1608Metric
R6: 47.5k; R_0603_1608Metric
R7, R8: 1K; RESC1608X55N
R9, R41: 0; RESC1608X55N
R10, R19, R21, R32, R40: 10k; RESC1608X55N
R11: 1k; R_0603_1608Metric
R13, R14, R15: 270; RESC1608X55N
R16, R34: 100k; RESC1608X55N
R17: 100; RESC1608X55N
R18: 4.7k; RESC1608X55N
R20: 20k; RESC1608X55N
R22: 1k; RESC1608X55N
R23: 220k; RESC2012X60N
R24: 30k; RESC2012X60N
R25: 30k; R_0805_2012Metric
R26: 100K; RESC2012X60N
R27: 20k; RESC2012X60N
R28: 1.1M; RESC3116X65N
R29: 59k; RESC2012X60N
R30: 100k; RESC2012X60N
R31: 1M; RESC1608X55N
R33: 43.2k; RESC1608X55N
R35: 45.3k; RESC1608X55N
R36: 500m; CSR1206
R38: 100K; RESC1608X55N
SW1: RESET; SW_SPST_SKQG_WithStem
SW2: BOOT; SW_SPST_SKQG_WithStem

Connections:
+3.3V: C3.1, C4.1, C5.1, C6.1, C19.1, C28.1, C31.1, IC1.2 (3V3), IC2.6 (VDD), IC2.7 (VREGIN), IC3.3 (VOUT), J1.1, J8.1, R10.2, R11.2, R18.1, R21.2, R43.2
+5V: C1.1, C2.1, C16.1, C17.1, C20.1, C22.1, C24.1, C26.1, C27.1, C29.1, C30.1, IC3.1 (VIN), J3.2, J6.2, J7.2, JP3.2 (B), L1.1, R23.1
+5VBUS: JP3.1 (A), P1.A4 (VBUS), P1.A9 (VBUS), P1.B4 (VBUS), P1.B9 (VBUS), R5.1
+12V: C10.1, C11.1, C12.1, C13.1, C14.1, C15.1, C18.1, C21.1, C23.1, C32.1, C33.2, C34.2, D8.1 (K), D10.1 (K), IC4.1 (VIN), IC5.4 (VIN), J5.1, L2.1, R25.2, R28.1
D+: D2.1 (K), IC2.4 (D+), P1.A6 (D+), P1.B6 (D+)
D-: D3.1 (K), IC2.5 (D-), P1.A7 (D-), P1.B7 (D-)
DTR: IC2.28 (DTR), Q2.2 (E), R1.1
EN: D11.1 (K), IC1.26 (IO4), IC4.5 (EN), R25.1, R26.2, R27.2
FLOW_FAULT: IC1.28 (IO17), R14.2
FLOW_SGN: IC1.10 (IO25), J7.3, R21.1
GND: C1.2, C2.2, C3.2, C4.2, C5.2, C6.2, C7.1, C8.1, C9.1, C10.2, C11.2, C12.2, C13.2, C14.2, C15.2, C16.2, C17.2, C18.2, C19.2, C20.2, C21.2, C22.2, C23.2, C24.2, C25.2, C26.2, C27.2, C28.2, C29.2, C30.2, C31.2, C32.2, C33.1, C34.1, C35.2, C37.1, C38.2, C39.1, C40.2, C41.2, C42.2, D1.1 (K), D2.2 (A), D3.2 (A), D4.1 (K), D5.1 (K), D6.1 (K), D7.1 (K), D9.2 (A2), D11.2 (A), IC1.1 (GND_1), IC1.15 (GND_2), IC1.38 (GND_3), IC1.39 (GND_4), IC1.40 (GND_5), IC1.41 (GND_6), IC1.42 (GND_7), IC1.43 (GND_8), IC1.44 (GND_9), IC1.45 (GND_10), IC1.46 (GND_11), IC1.47 (GND_12), IC2.3 (GND_1), IC2.29 (GND_2), IC3.2 (GND_1), IC3.4 (GND_2), IC4.3 (GND), IC4.4 (AGND), IC5.17 (SYNC/SPRD), IC5.18 (RP), IC5.22 (GND_1), IC5.23 (GND_2), IC5.29 (GND_3), J1.4, J3.1, J4.2, J4.3, J6.1, J7.1, J8.2, J9.2, P1.A1 (GND), P1.A12 (GND), P1.B1 (GND), P1.B12 (GND), P1.S1 (SHIELD), Q3.3 (S), R3.2, R6.2, R12.2, R16.1, R20.2, R24.2, R26.1, R27.1, R30.2, R33.2, R35.2, R39.2, R40.2, SW1.1, SW2.1
INTV: C35.1, IC5.3 (INTVCC), R34.2
IO0: C9.2, IC1.25 (IO0), Q2.3 (C), R43.1, SW2.2
ISN: IC5.10 (ISN), Q4.3 (S), R36.2, R38.2
ISP: C40.1, C41.1, C42.1, IC5.9 (ISP), IC5.21 (VOUT_1), IC5.24 (VOUT_2), R31.1, R36.1
LEDS: J9.1, Q4.1 (D)
MCU_EN: C8.2, IC1.3 (EN), Q1.3 (C), R9.2, R10.1
unnamed: C7.2, R9.1, SW1.2
unnamed: C38.1, R32.1
unnamed: D1.2 (A), R7.2
unnamed: D4.2 (A), R8.2
unnamed: D5.2 (A), R13.2
unnamed: D6.2 (A), R14.1
unnamed: D7.2 (A), R15.1
unnamed: D8.2 (A), J5.2, Q3.1 (D)
unnamed: D9.1 (A1), D10.2 (A), F1.2
unnamed: F1.1, J4.1
unnamed: IC1.30 (IO18), R41.1
unnamed: IC2.9 (RSTB), R11.1
unnamed: IC2.11 (SUSPENDB), R12.1
unnamed: IC4.6 (FB), R23.2, R24.1
unnamed: IC4.2 (SW), L1.2
unnamed: C36.2, IC5.2 (BST)
unnamed: C37.2, IC5.7 (VREF), IC5.8 (CTRL)
unnamed: IC5.5 (EN/UVLO), R28.2, R29.1
unnamed: IC5.12 (FB), R31.2, R33.1
unnamed: IC5.6 (OVLO), R29.2, R30.1
unnamed: IC5.20 (PWMTG), R37.1
unnamed: IC5.16 (RT), R35.1
unnamed: C39.2, IC5.13 (SS)
unnamed: IC5.11 (VC), R32.2
unnamed: IC5.15 (~FAULT), R34.1
unnamed: J3.3, R4.2
unnamed: J6.3, R19.1
unnamed: P1.A5 (CC1), R3.1
unnamed: P1.B5 (CC2), R39.1
unnamed: Q1.1 (B), R1.2
unnamed: Q2.1 (B), R2.2
unnamed: Q3.2 (G), R17.2
unnamed: Q4.2 (G), R37.2, R38.1
unnamed: R19.2, R20.1, R22.1
PH_FAULT: IC1.9 (IO33), R13.1
PH_SGN: C25.1, IC1.8 (IO32), R22.2
PUMP_SGN: IC1.12 (IO27), R16.2, R17.1
PWM_DIM: IC5.19 (PWM), R40.1, R41.2
RTS: IC2.24 (RTS), Q1.2 (E), R2.1
RX: IC2.25 (RXD), NT1.2
RXD0: IC1.34 (RXD0), J1.3, NT2.1, R8.1
SRV_SGN: IC1.11 (IO26), R4.1
SW: C36.1, IC5.1 (SW_1), IC5.27 (SW_2), IC5.28 (SW_3), L2.2
TCK: IC1.16 (IO13), J2.3
TDI: IC1.14 (IO12), J2.2
TDO: IC1.23 (IO15), J2.4
TEMP_FAULT: IC1.29 (IO5), R15.2
TMP_SGN: IC1.31 (IO19), J8.3, R18.2
TMS: IC1.13 (IO14), J2.1
TX: IC2.26 (TXD), NT2.2
TXD0: IC1.35 (TXD0), J1.2, NT1.1, R7.1
VBUS: IC2.8 (VBUS), R5.2, R6.1

Notes on the sheet:
R4 is a pulldown when using the EN signal from a GPIO of the microcontroller, whereas R3, R7 and D3 are for when you just want EN to be always high.
Do not place either R4, or R3, R7 and D3.
VDD
3V3
VREGIN
5-3.3V LDO
Sensor Inputs
12V Power Input
Fault LEDs
USB-to-UART Programmer
LED Driver
Servo Motor
Microcontroller
Water Pump
12-5V Buck Converter

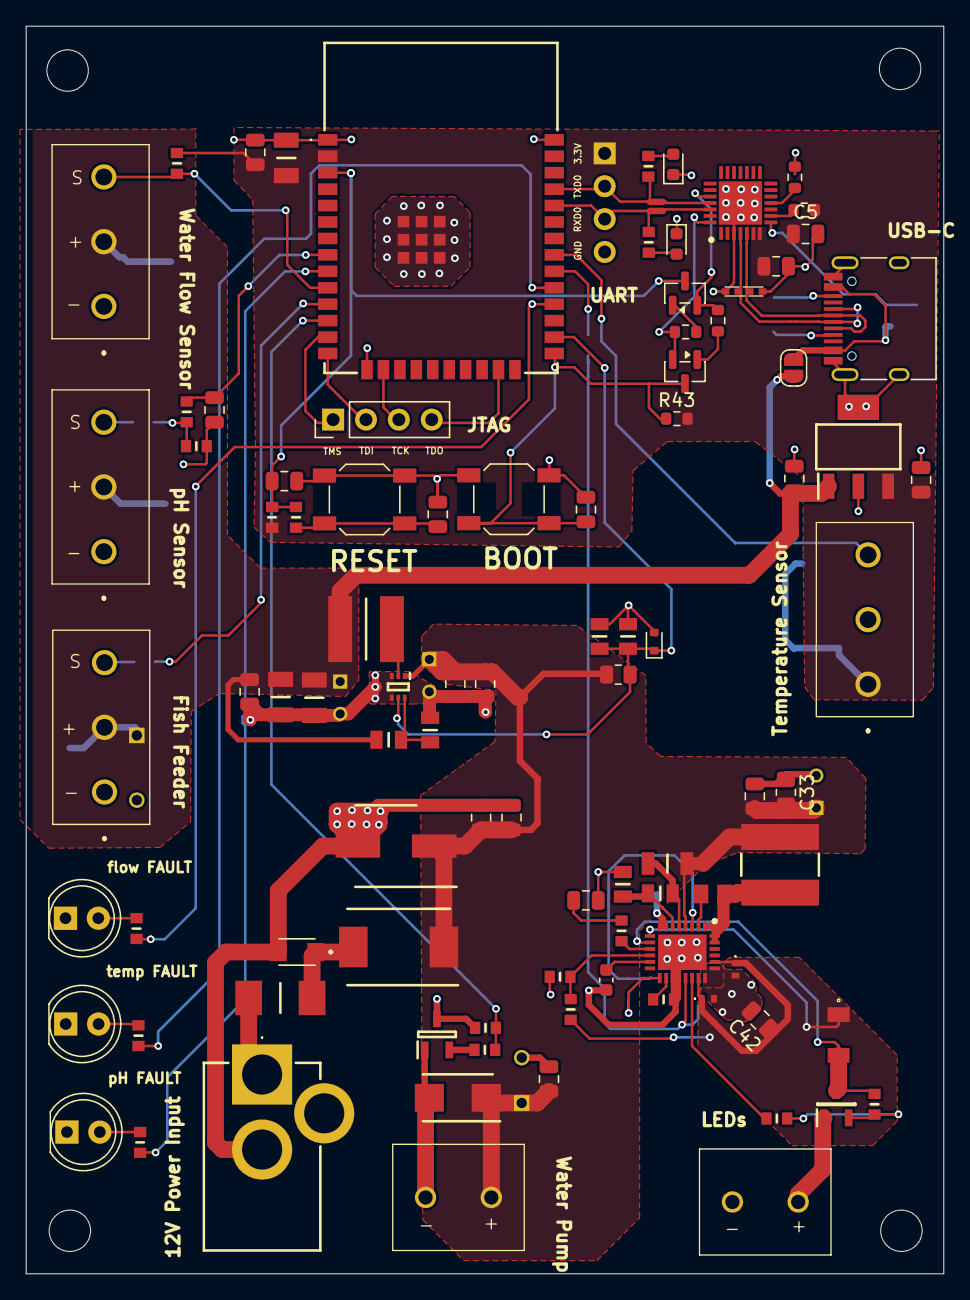
[picture p101: board circle_of_life_v2.kicad_pcb from above]

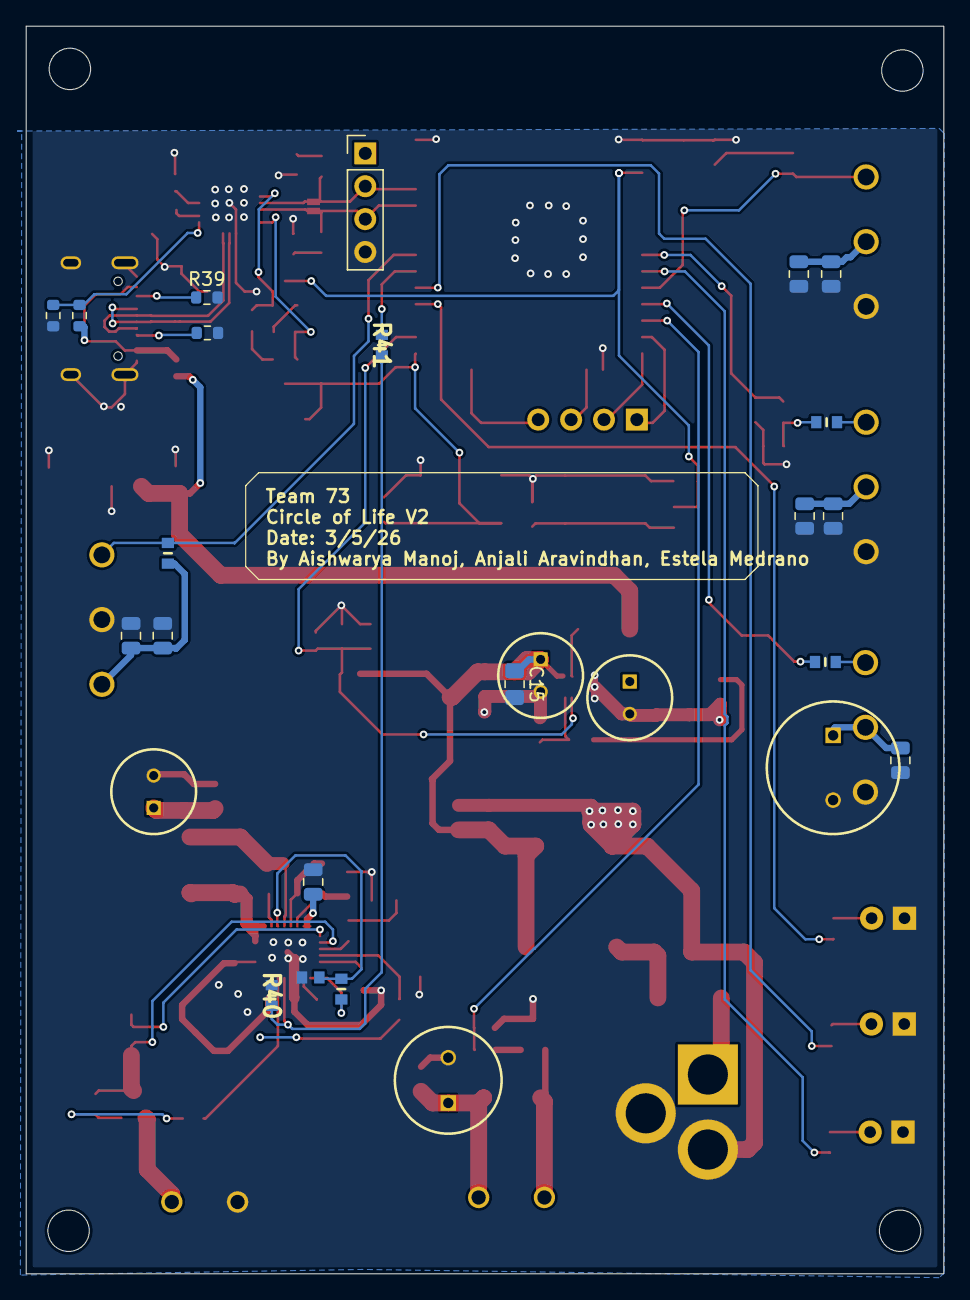
[picture p102: board circle_of_life_v2.kicad_pcb from below]

Board: 2 copper layers, 70.9 x 96.4 mm, 126 parts (26 on the bottom side), 69 nets.
