anjalia2/ECE-445-Project/boards/grow_lights/grow_lights.kicad_pcb

## KiCad design boards/grow_lights/grow_lights.kicad_pcb (2026-03-27)

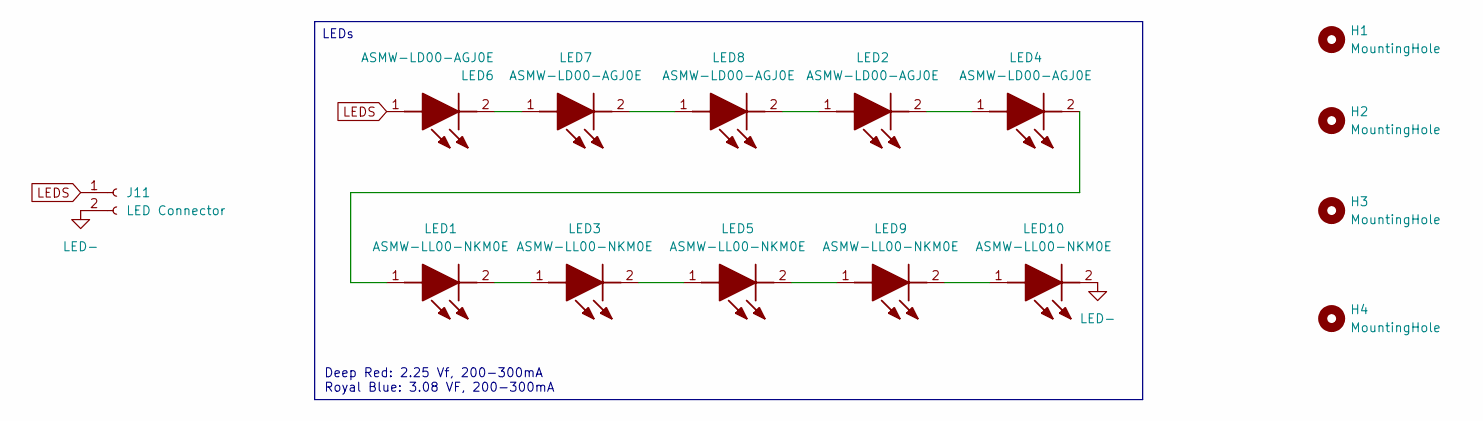
[picture p103: schematic grow_lights.kicad_sch]

Parts:
H1, H2, H3, H4: MountingHole; MountingHole_3.2mm_M3
J11: LED Connector; 2828372
LED1, LED3, LED5, LED9, LED10: ASMW-LL00-NKM0E; ASMWLL00NKM0E; Mouser Part Number 630-ASMW-LL00-NKM0E
LED2, LED4, LED6, LED7, LED8: ASMW-LD00-AGJ0E; ASMWLL00NKM0E; Mouser Part Number 630-ASMW-LL00-NKM0E

Connections:
LED-: J11.2, LED10.2 (K)
LEDS: J11.1, LED6.1 (A)
unnamed: LED1.1 (A), LED4.2 (K)
unnamed: LED1.2 (K), LED3.1 (A)
unnamed: LED2.1 (A), LED8.2 (K)
unnamed: LED2.2 (K), LED4.1 (A)
unnamed: LED3.2 (K), LED5.1 (A)
unnamed: LED5.2 (K), LED9.1 (A)
unnamed: LED6.2 (K), LED7.1 (A)
unnamed: LED7.2 (K), LED8.1 (A)
unnamed: LED9.2 (K), LED10.1 (A)

Notes on the sheet:
Deep Red: 2.25 Vf, 200-300mA Royal Blue: 3.08 VF, 200-300mA
LEDs

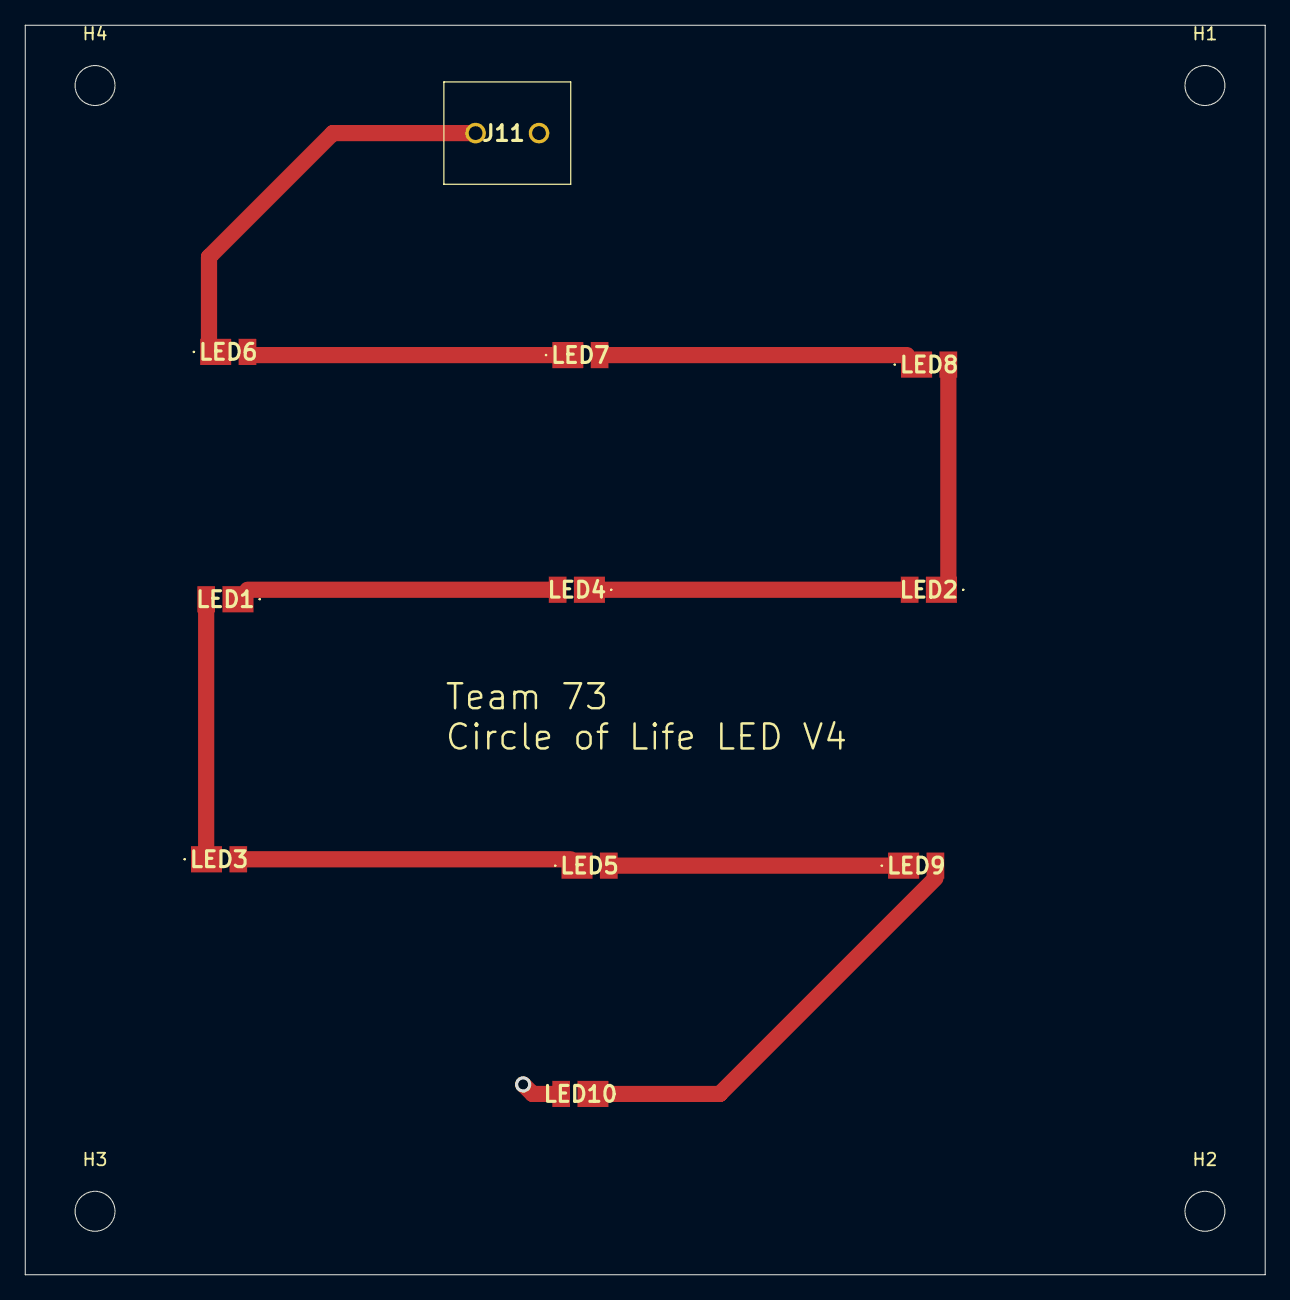
[picture p104: board grow_lights.kicad_pcb from above]

Board: 2 copper layers, 99.3 x 100.1 mm, 15 parts (0 on the bottom side), 11 nets.
