anjalia2/ECE-445-Project/boards/circle_of_life/circle_of_life.kicad_pcb

## KiCad design boards/circle_of_life/circle_of_life.kicad_pcb (2026-02-26)

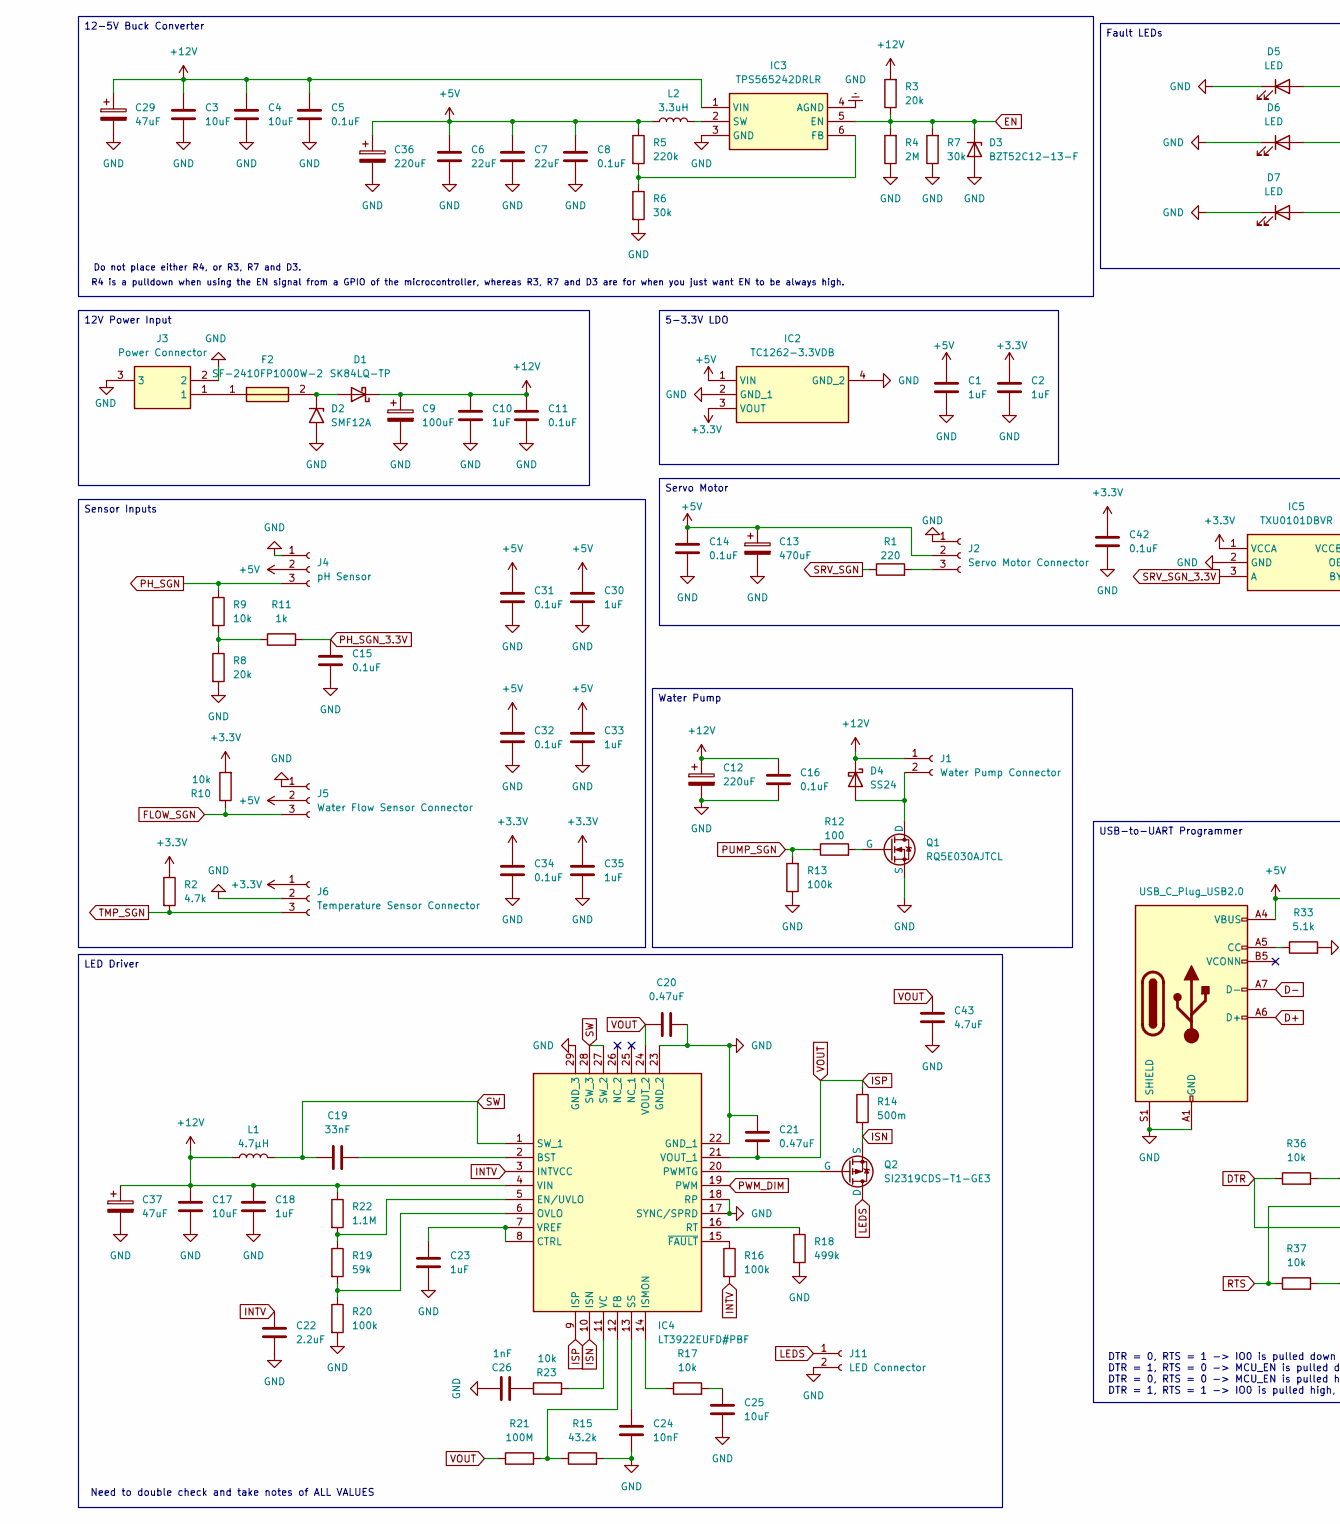
[picture p105: schematic circle_of_life.kicad_sch, part in row 1, column 1]

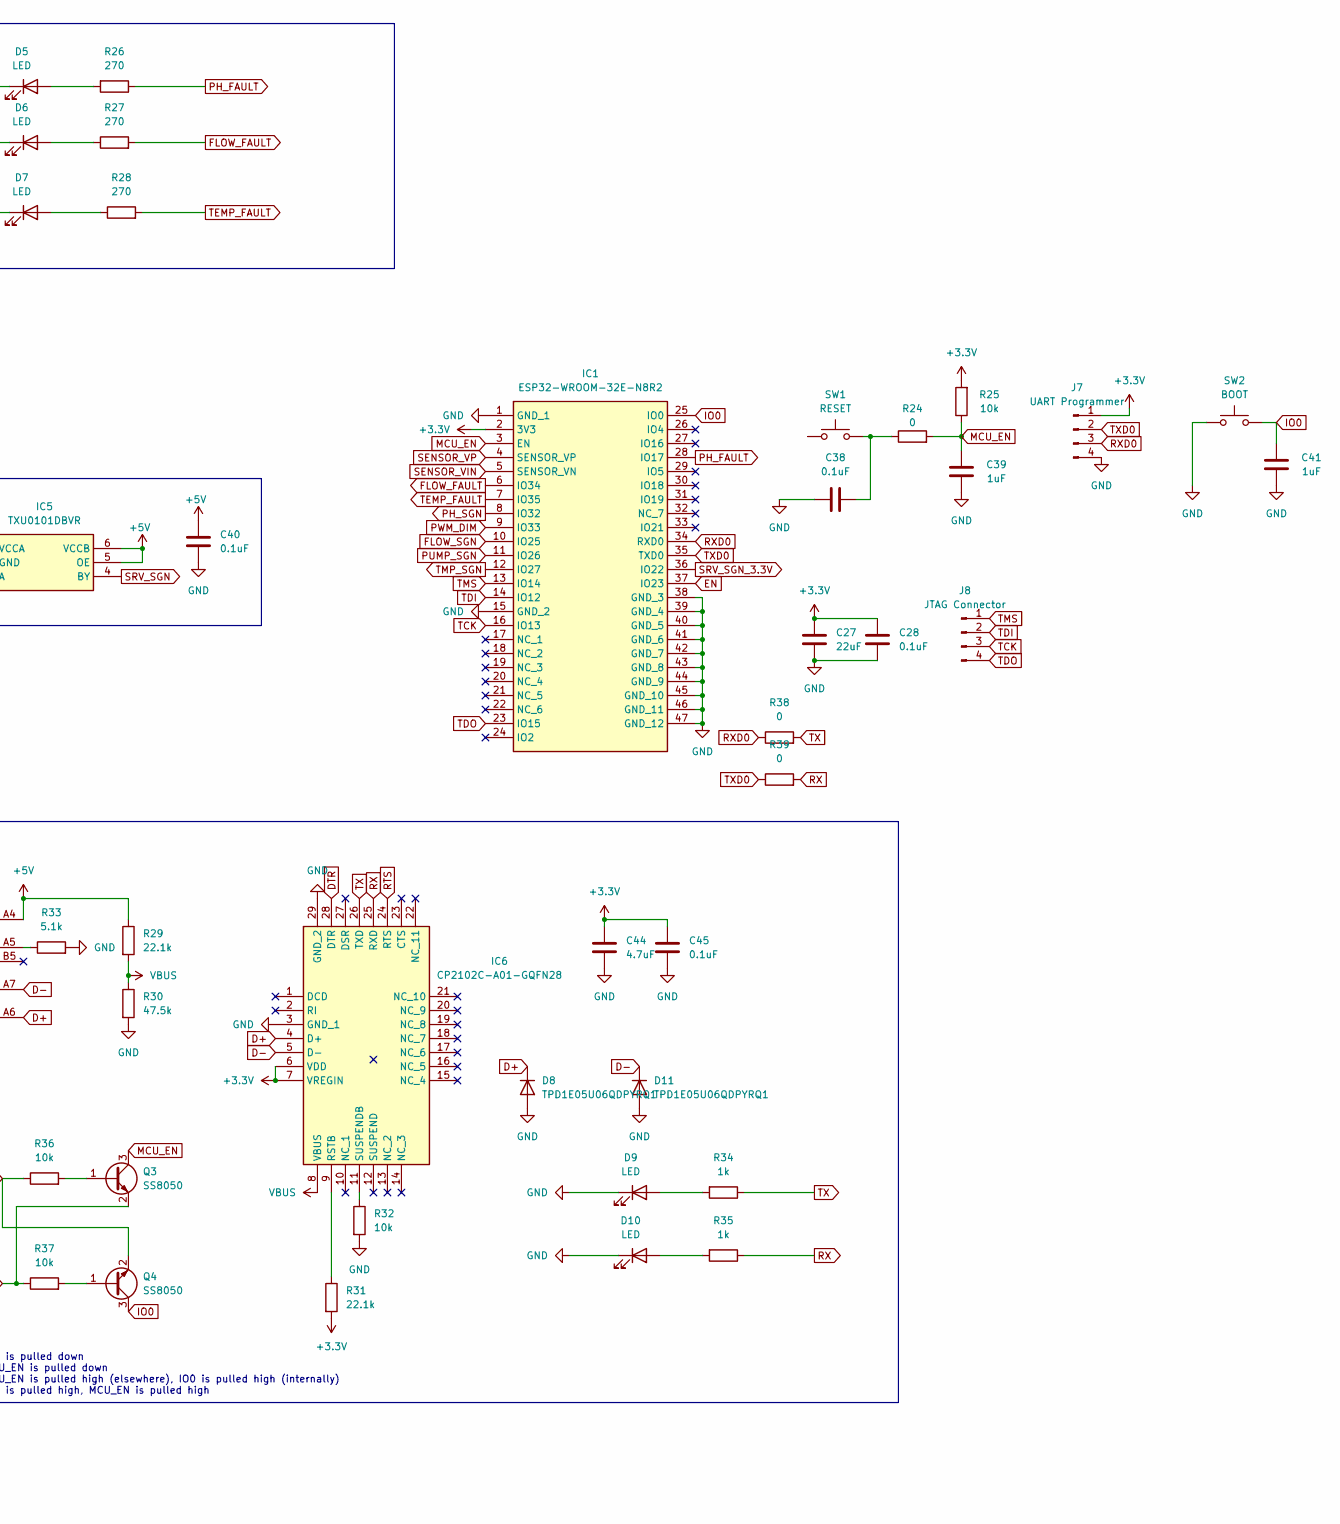
[picture p106: schematic circle_of_life.kicad_sch, part in row 1, column 2]

Parts:
C1, C2, C10, C18, C23, C30, C33, C35, C39, C41: 1uF; C_0805_2012Metric
C3, C4, C25: 10uF; C_0805_2012Metric
C5, C8, C11, C14, C15, C16, C28, C31, C32, C34, C38, C40: 0.1uF; C_0805_2012Metric
C6, C7, C27: 22uF; CAPC3216X190N
C9: 100uF; CAPAE630X800N
C12, C36: 220uF; CAPPRD350W60D825H1300
C13: 470uF; CAPPRD500W60D1025H1400
C17: 10uF; CAPC3216X180N
C19: 33nF; 0805_AVX
C20, C21: 0.47uF; GRM15x
C22: 2.2uF; CAPC1608X90N
C24: 10nF; C_0603_1608Metric
C26: 1nF; C_0805_2012Metric
C29, C37: 47uF; CAPPRD250W50D655H1250
C42, C45: 0.1uF; C_0603_1608Metric
C43: 4.7uF; C_1206_3216Metric
C44: 4.7uF; C_0805_2012Metric
D1: SK84LQ-TP; DIOM7959X262N
D2: SMF12A; TVS_SMF12A
D3: BZT52C12-13-F; SOD3716X145N
D4: SS24; DIOM5436X247N
D5, D6, D7: LED; LED_D5.0mm
D8, D11: TPD1E05U06QDPYRQ1; DPY_R-PX1SON-N2_
D9, D10: LED; LED_0603_1608Metric
F2: SF-2410FP1000W-2; FUSC6125X236N; Mouser Part Number 652-SF-2410FP1000W-2
IC1: ESP32-WROOM-32E-N8R2; ESP32WROOM32EN8R2; Mouser Part Number 356-ESP32WRM32EN8R2
IC2: TC1262-3.3VDB; SOT230P700X180-4N; Mouser Part Number 579-TC1262-3.3VDB
IC3: TPS565242DRLR; SOTFL50P160X60-6N; Mouser Part Number 595-TPS565242DRLR
IC4: LT3922EUFD#PBF; QFN50P400X500X80-29N-D; Mouser Part Number 584-LT3922EUFD#PBF
IC5: TXU0101DBVR; SOT95P280X145-6N; Mouser Part Number 595-TXU0101DBVR
IC6: CP2102C-A01-GQFN28; QFN50P500X500X80-29N-D; Mouser Part Number 634-P2102CA01GQFN28
J1: Water Pump Connector; 2828372
J2: Servo Motor Connector; 691137710003
J3: Power Connector; 694108301002; Mouser Part Number 710-694108301002
J4: pH Sensor; 691137710003
J5: Water Flow Sensor Connector; 691137710003
J6: Temperature Sensor Connector; 691137710003
J7: UART Programmer; PinHeader_1x04_P2.54mm_Vertical
J8: JTAG Connector; PinHeader_1x04_P2.54mm_Vertical
J11: LED Connector; 2828372
L1: 4.7µH; SRN6045_1
L2: 3.3uH; INDC4949X330N
P1: USB_C_Plug_USB2.0; USB_C_Receptacle_HRO_TYPE-C-31-M-12
Q1: RQ5E030AJTCL; SOT95P280X100-3N
Q2: SI2319CDS-T1-GE3; SOT95P237X112-3N
Q3, Q4: SS8050; SOT-23
R1: 220; RESC1608X55N
R2: 4.7k; RESC1608X55N
R3: 20k; R_0805_2012Metric
R4: 2M; RESC2012X60N
R5: 220k; RESC2012X60N
R6, R7: 30k; RESC2012X60N
R8: 20k; RESC1608X55N
R9, R10, R17, R23, R25: 10k; RESC1608X55N
R11, R34, R35: 1k; RESC1608X55N
R12: 100; RESC1608X55N
R13, R16: 100k; RESC1608X55N
R14: 500m; CSR1206
R15: 43.2k; RESC1608X55N
R18: 499k; RESC1608X55N
R19: 59k; RESC2012X60N
R20: 100k; RESC2012X60N
R21: 100M; RESC1608X55N
R22: 1.1M; RESC3116X65N
R24: 0; RESC1608X55N
R26, R27, R28: 270; RESC1608X55N
R29, R31: 22.1k; R_0603_1608Metric
R30: 47.5k; R_0603_1608Metric
R32, R36, R37: 10k; R_0603_1608Metric
R33: 5.1k; R_0603_1608Metric
R38, R39: 0; R_0603_1608Metric
SW1: RESET; SW_SPST_SKQG_WithStem
SW2: BOOT; SW_SPST_SKQG_WithStem

Connections:
+3.3V: C2.1, C27.1, C28.1, C34.1, C35.1, C42.1, C44.1, C45.1, IC1.2 (3V3), IC2.3 (VOUT), IC5.1 (VCCA), IC6.6 (VDD), IC6.7 (VREGIN), J6.1, J7.1, R2.1, R10.2, R25.2, R31.2
+5V: C1.1, C6.1, C7.1, C8.1, C13.1, C14.1, C30.1, C31.1, C32.1, C33.1, C36.1, C40.1, IC2.1 (VIN), IC5.5 (OE), IC5.6 (VCCB), J2.2, J4.2, J5.2, L2.1, P1.A4 (VBUS), P1.A9 (VBUS), P1.B4 (VBUS), P1.B9 (VBUS), R5.1, R29.1
+12V: C3.1, C4.1, C5.1, C9.1, C10.1, C11.1, C12.1, C16.1, C17.2, C18.2, C29.1, C37.1, D1.1 (K), D4.1 (K), IC3.1 (VIN), IC4.4 (VIN), J1.1, L1.1, R3.2, R22.1
D+: D8.1 (K), IC6.4 (D+), P1.A6 (D+)
D-: D11.1 (K), IC6.5 (D-), P1.A7 (D-)
DTR: IC6.28 (DTR), Q4.2 (E), R36.1
EN: D3.1 (K), IC1.37 (IO23), IC3.5 (EN), R3.1, R4.2, R7.2
FLOW_FAULT: IC1.6 (IO34), R27.2
FLOW_SGN: IC1.10 (IO25), J5.3, R10.1
GND: C1.2, C2.2, C3.2, C4.2, C5.2, C6.2, C7.2, C8.2, C9.2, C10.2, C11.2, C12.2, C13.2, C14.2, C15.2, C16.2, C17.1, C18.1, C20.2, C21.2, C22.2, C23.1, C24.1, C25.1, C26.2, C27.2, C28.2, C29.2, C30.2, C31.2, C32.2, C33.2, C34.2, C35.2, C36.2, C37.2, C38.1, C39.1, C40.2, C41.1, C42.2, C43.2, C44.2, C45.2, D2.2 (A2), D3.2 (A), D5.1 (K), D6.1 (K), D7.1 (K), D8.2 (A), D9.1 (K), D10.1 (K), D11.2 (A), IC1.1 (GND_1), IC1.15 (GND_2), IC1.38 (GND_3), IC1.39 (GND_4), IC1.40 (GND_5), IC1.41 (GND_6), IC1.42 (GND_7), IC1.43 (GND_8), IC1.44 (GND_9), IC1.45 (GND_10), IC1.46 (GND_11), IC1.47 (GND_12), IC2.2 (GND_1), IC2.4 (GND_2), IC3.3 (GND), IC3.4 (AGND), IC4.17 (SYNC/SPRD), IC4.18 (RP), IC4.22 (GND_1), IC4.23 (GND_2), IC4.29 (GND_3), IC5.2 (GND), IC6.3 (GND_1), IC6.29 (GND_2), J2.1, J3.2, J3.3, J4.1, J5.1, J6.2, J7.4, J11.2, P1.A1 (GND), P1.A12 (GND), P1.B1 (GND), P1.B12 (GND), P1.S1 (SHIELD), Q1.3 (S), R4.1, R6.2, R7.1, R8.2, R13.1, R15.2, R18.2, R20.2, R30.2, R32.2, R33.2, SW2.1
INTV: C22.1, IC4.3 (INTVCC), R16.2
IO0: C41.2, IC1.25 (IO0), Q4.3 (C), SW2.2
ISN: IC4.10 (ISN), Q2.3 (S), R14.2
ISP: C20.1, C21.1, C43.1, IC4.9 (ISP), IC4.21 (VOUT_1), IC4.24 (VOUT_2), R14.1, R21.1
LEDS: J11.1, Q2.1 (D)
MCU_EN: C39.2, IC1.3 (EN), Q3.3 (C), R24.2, R25.1
unnamed: C25.2, R17.2
unnamed: C26.1, R23.1
unnamed: C38.2, R24.1, SW1.2
unnamed: D1.2 (A), D2.1 (A1), F2.2
unnamed: D4.2 (A), J1.2, Q1.1 (D)
unnamed: D5.2 (A), R26.2
unnamed: D6.2 (A), R27.1
unnamed: D7.2 (A), R28.1
unnamed: D9.2 (A), R34.2
unnamed: D10.2 (A), R35.2
unnamed: F2.1, J3.1
unnamed: IC3.6 (FB), R5.2, R6.1
unnamed: IC3.2 (SW), L2.2
unnamed: C19.2, IC4.2 (BST)
unnamed: C23.2, IC4.7 (VREF), IC4.8 (CTRL)
unnamed: IC4.5 (EN/UVLO), R19.1, R22.2
unnamed: IC4.12 (FB), R15.1, R21.2
unnamed: IC4.14 (ISMON), R17.1
unnamed: IC4.6 (OVLO), R19.2, R20.1
unnamed: IC4.20 (PWMTG), Q2.2 (G)
unnamed: IC4.16 (RT), R18.1
unnamed: C24.2, IC4.13 (SS)
unnamed: IC4.11 (VC), R23.2
unnamed: IC4.15 (~FAULT), R16.1
unnamed: IC6.9 (RSTB), R31.1
unnamed: IC6.11 (SUSPENDB), R32.1
unnamed: J2.3, R1.2
unnamed: P1.A5 (CC), R33.1
unnamed: Q1.2 (G), R12.2
unnamed: Q3.1 (B), R36.2
unnamed: Q4.1 (B), R37.2
unnamed: R8.1, R9.2, R11.1
PH_FAULT: IC1.28 (IO17), R26.1
PH_SGN: IC1.8 (IO32), J4.3, R9.1
PH_SGN_3.3V: C15.1, R11.2
PUMP_SGN: IC1.11 (IO26), R12.1, R13.2
PWM_DIM: IC1.9 (IO33), IC4.19 (PWM)
RTS: IC6.24 (RTS), Q3.2 (E), R37.1
RX: IC6.25 (RXD), R35.1, R39.2
RXD0: IC1.34 (RXD0), J7.3, R38.1
SENSOR_VIN: IC1.5 (SENSOR_VN)
SENSOR_VP: IC1.4 (SENSOR_VP)
SRV_SGN: IC5.4 (BY), R1.1
SRV_SGN_3.3V: IC1.36 (IO22), IC5.3 (A)
SW: C19.1, IC4.1 (SW_1), IC4.27 (SW_2), IC4.28 (SW_3), L1.2
TCK: IC1.16 (IO13), J8.3
TDI: IC1.14 (IO12), J8.2
TDO: IC1.23 (IO15), J8.4
TEMP_FAULT: IC1.7 (IO35), R28.2
TMP_SGN: IC1.12 (IO27), J6.3, R2.2
TMS: IC1.13 (IO14), J8.1
TX: IC6.26 (TXD), R34.1, R38.2
TXD0: IC1.35 (TXD0), J7.2, R39.1
VBUS: IC6.8 (VBUS), R29.2, R30.1

Notes on the sheet:
R4 is a pulldown when using the EN signal from a GPIO of the microcontroller, whereas R3, R7 and D3 are for when you just want EN to be always high.
DTR = 0, RTS = 1 -> IO0 is pulled down DTR = 1, RTS = 0 -> MCU_EN is pulled down DTR = 0, RTS = 0 -> MCU_EN is pulled high (elsewhere), IO0 is pulled high (internally) DTR = 1, RTS = 1 -> IO0 is pulled high, MCU_EN is pulled high
Need to double check and take notes of ALL VALUES
Do not place either R4, or R3, R7 and D3.
5-3.3V LDO
Water Pump
12-5V Buck Converter
Sensor Inputs
LED Driver
USB-to-UART Programmer
Fault LEDs
12V Power Input
Servo Motor
