anjalia2/ECE-445-Project/boards/circle_of_life/circle_of_life.kicad_pcb

## KiCad design boards/circle_of_life/circle_of_life.kicad_pcb (continued)

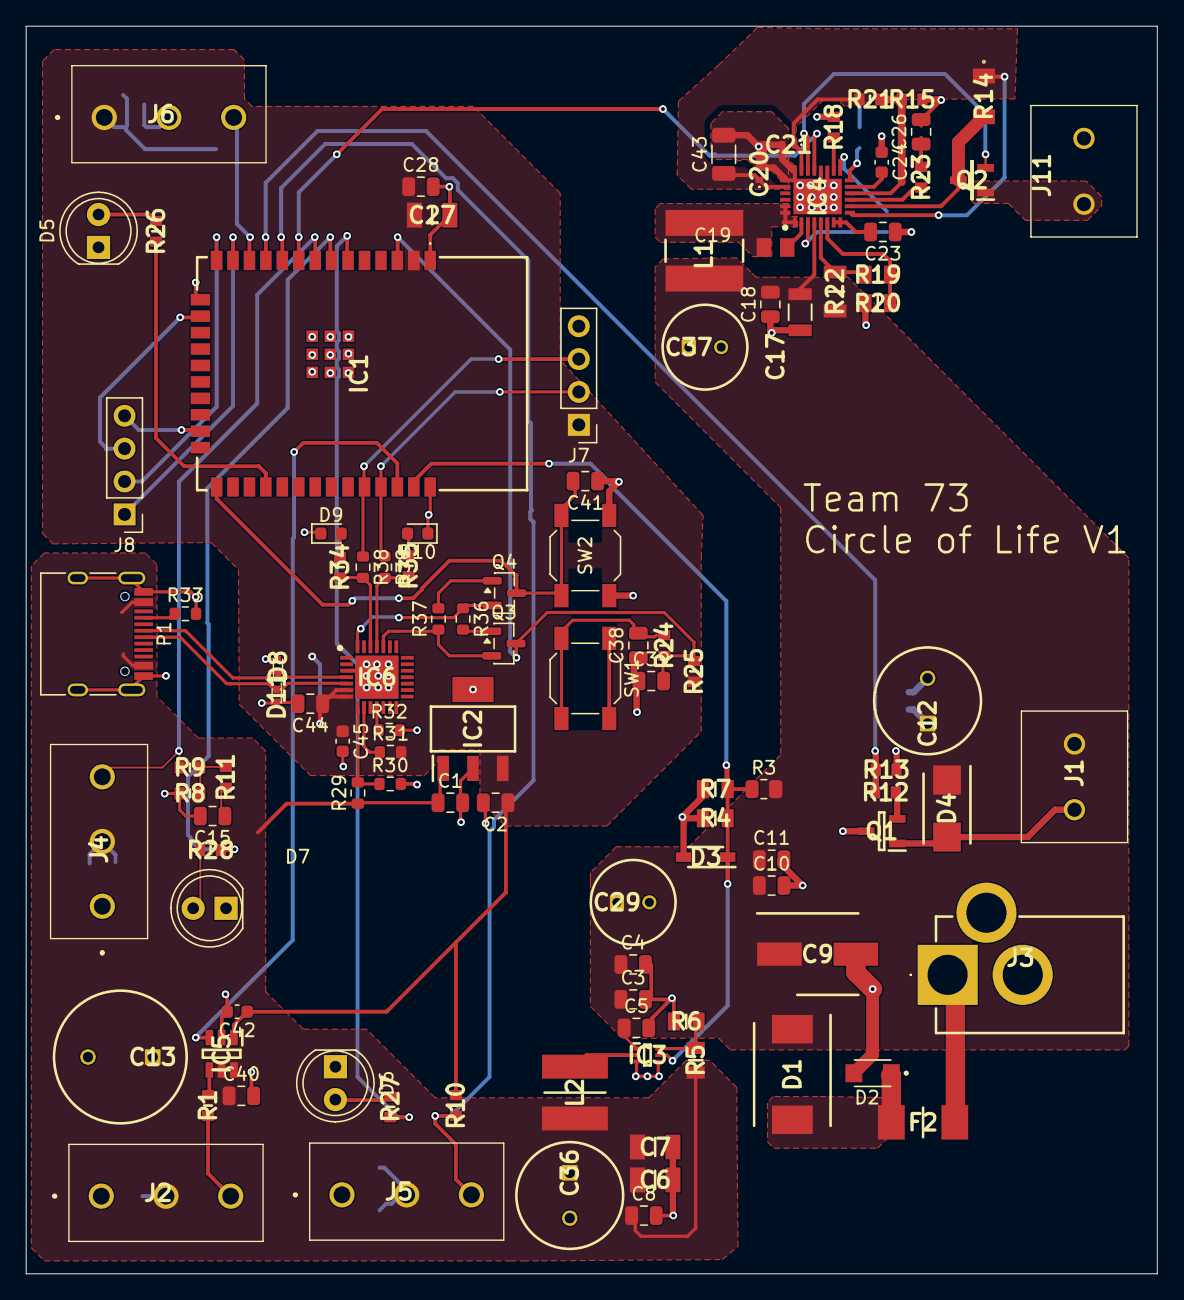
[picture p107: board circle_of_life.kicad_pcb from above]

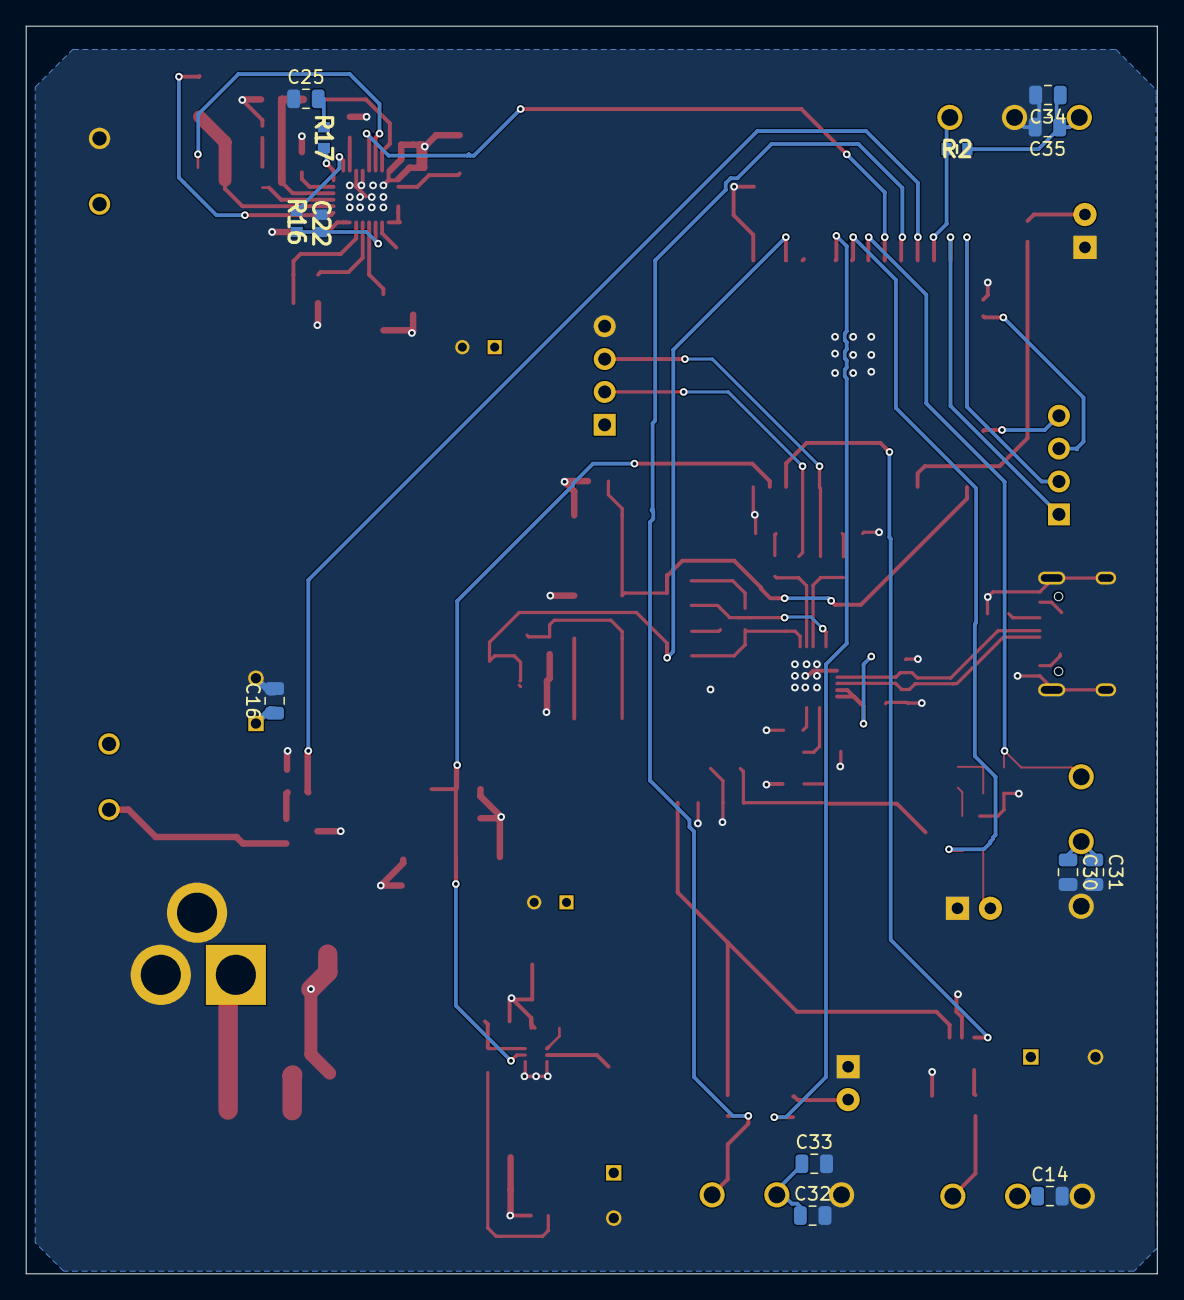
[picture p108: board circle_of_life.kicad_pcb from below]

Board: 2 copper layers, 87.4 x 96.4 mm, 120 parts (13 on the bottom side), 68 nets.
