anjalia2/ECE-445-Project/(commit log)

2026-02-19 Finalized first draft of schematic, missing inductor value for LED driver, rechecking all values, and adding footprints
    [circle_of_life.kicad_pcb, circle_of_life.kicad_sch]
2026-02-19 started assigning footprints
    [694108301002.stp, EEV107M035A9HAA.stp, GMK107B7104KAHT.stp, GMK212B7105KG-T.stp, RQ5E030AJTCL.stp, SF-2410FP1000W-2.stp, SS24.stp, circle_of_life.kicad_sch]
2026-02-19 more footprint assignments
    [ASMW-L300-AFH0E.stp, ASMW-LL00-NKM0E.stp, BZT52C12-13-F.stp, SK84LQ-TP.stp, circle_of_life.kicad_sch]
2026-02-20 finished 74 out of 101 footprints
    [282837-2.stp, 35PX470MEFC10X12.5.stp, 35ZLH220MEFCT78X11.5.stp, 50YXJ47M6.3X11.stp, 691137710003.stp, C0603C103K5RACTU.stp, GRM155R61H474KE11D.stp, GRM155R71H102KA01D.stp]
2026-02-20 most resistor footprints added, need to check
    [EDI2CAP.CFG, RC0603FR-7W10KL.stp, RC0805FR-0730KL.SchLib, RC0805FR-0730KL.stp, RC1206FR-071M1L.stp, RCWE1206.STEP, RESC2012X60N.PcbLib, chips.prt]
2026-02-20 Added level shifter to servo motor, and initiated layout, no routing yet
    [CSR1206FTR500.stp, ESP32-WROOM-32E-N8R2.stp, LT3922EUFD#PBF.stp, SI2318CDS-T1-GE3.stp, SI2319CDS-T1-GE3.stp, TC1262-3.3VDB.stp, TPS565242DRLR.stp, TXU0101DBVR.stp]
2026-02-20 slightly modified it
    [circle_of_life.kicad_pcb, circle_of_life.kicad_sch]
2026-02-21 added usb-uart programmer so that its easier to program :D
    [CP2102C-A01-GQFN28.stp, SP0503BAHTG.stp, SP0506BAATG.stp, SS8050-G.stp, circle_of_life.kicad_pcb, circle_of_life.kicad_sch]
2026-02-23 5V signal routing done
    [circle_of_life.kicad_pcb]
2026-02-23 mcu connections started
    [circle_of_life.kicad_pcb]
2026-02-23 modified layout rip
    [ESP32-S3-WROOM-1-N8.stp, TPD1E05U06QDPYRQ1.stp, circle_of_life.kicad_pcb, circle_of_life.kicad_sch]
2026-02-23 modified current sensor cause i just couldnt leave it like that
    [circle_of_life.kicad_pcb]
2026-02-24 started grow lights PCB
    [grow_lights.kicad_pcb, grow_lights.kicad_sch]
2026-02-24 updated grow lights board with wider traces & removed power plane
    [grow_lights.kicad_pcb, grow_lights.kicad_sch]
2026-02-24 made LED- the back copper
    [grow_lights.kicad_pcb]
2026-02-25 fixed some footprints
    [circle_of_life.kicad_pcb, circle_of_life.kicad_sch, grow_lights.kicad_pcb]
2026-02-26 fixed most of the footprints errors
    [circle_of_life-B_Cu.gbr, circle_of_life-B_Mask.gbr, circle_of_life-B_Paste.gbr, circle_of_life-B_Silkscreen.gbr, circle_of_life-Edge_Cuts.gbr, circle_of_life-F_Cu.gbr, circle_of_life-F_Mask.gbr, circle_of_life-F_Paste.gbr]
2026-02-26 Fixed DRC for main board
    [circle_of_life.kicad_pcb, circle_of_life.kicad_sch]
2026-02-26 finished generating files and put them in files folder for each PCB, also have zipped them
    [circle_of_life-B_Cu.gbl, circle_of_life-B_Cu.gbr, circle_of_life-B_Mask.gbr, circle_of_life-B_Mask.gbs, circle_of_life-B_Paste.gbp, circle_of_life-B_Paste.gbr, circle_of_life-B_Silkscreen.gbo, circle_of_life-B_Silkscreen.gbr]
2026-02-27 modified some wrong values in led driver
    [circle_of_life.kicad_sch]
2026-02-27 changed value
    [circle_of_life.kicad_sch]
2026-03-05 Finished draft of second order PCB
    [circle_of_life_v2.kicad_pcb, circle_of_life_v2.kicad_sch]
2026-03-08 Added PCB V2
    [circle_of_life_v2-B_Cu.gbr, circle_of_life_v2-B_Mask.gbr, circle_of_life_v2-B_Paste.gbr, circle_of_life_v2-B_Silkscreen.gbr, circle_of_life_v2-Edge_Cuts.gbr, circle_of_life_v2-F_Cu.gbr, circle_of_life_v2-F_Mask.gbr, circle_of_life_v2-F_Paste.gbr]
2026-03-09 with commentd & fixed pH print logic
    [circle_of_life.ino]
2026-03-12 grow lights PCB
    [grow_lights-B_Cu.gbl, grow_lights-B_Cu.gbr, grow_lights-B_Mask.gbr, grow_lights-B_Mask.gbs, grow_lights-B_Paste.gbp, grow_lights-B_Paste.gbr, grow_lights-B_Silkscreen.gbo, grow_lights-B_Silkscreen.gbr]
2026-03-26 code and grow lights pcb updates
    [grow_lights.kicad_pcb, grow_lights.kicad_sch]
2026-03-26 Updated grow lights board
    [grow_lights-B_Cu.gbl, grow_lights-B_Cu.gbr, grow_lights-B_Mask.gbr, grow_lights-B_Mask.gbs, grow_lights-B_Paste.gbp, grow_lights-B_Paste.gbr, grow_lights-B_Silkscreen.gbo, grow_lights-B_Silkscreen.gbr]
2026-03-27 Routes fixed and resistors added
    [circle_of_life_v2.kicad_pcb, circle_of_life_v2.kicad_sch]
2026-04-10 temp sensor code
2026-04-16 pump code
2026-04-21 added led code
2026-04-23 new LED driver code to test
2026-04-26 changed prints & offsets
2026-05-07 Uploaded Estela notebook
    [circle_of_life_v2-B_Cu.gbr, circle_of_life_v2-B_Mask.gbr, circle_of_life_v2-B_Paste.gbr, circle_of_life_v2-B_Silkscreen.gbr, circle_of_life_v2-Edge_Cuts.gbr, circle_of_life_v2-F_Cu.gbr, circle_of_life_v2-F_Mask.gbr, circle_of_life_v2-F_Paste.gbr]
